leontodon1/1pps_flasher/README.md

# 1pps_flasher
flash device using pps signal and NMEA data of a GPS module for purpose of time stamping astronomical videos
