leontodon1/1pps_flasher/docs/speech_BjKa_ESOP45.pdf

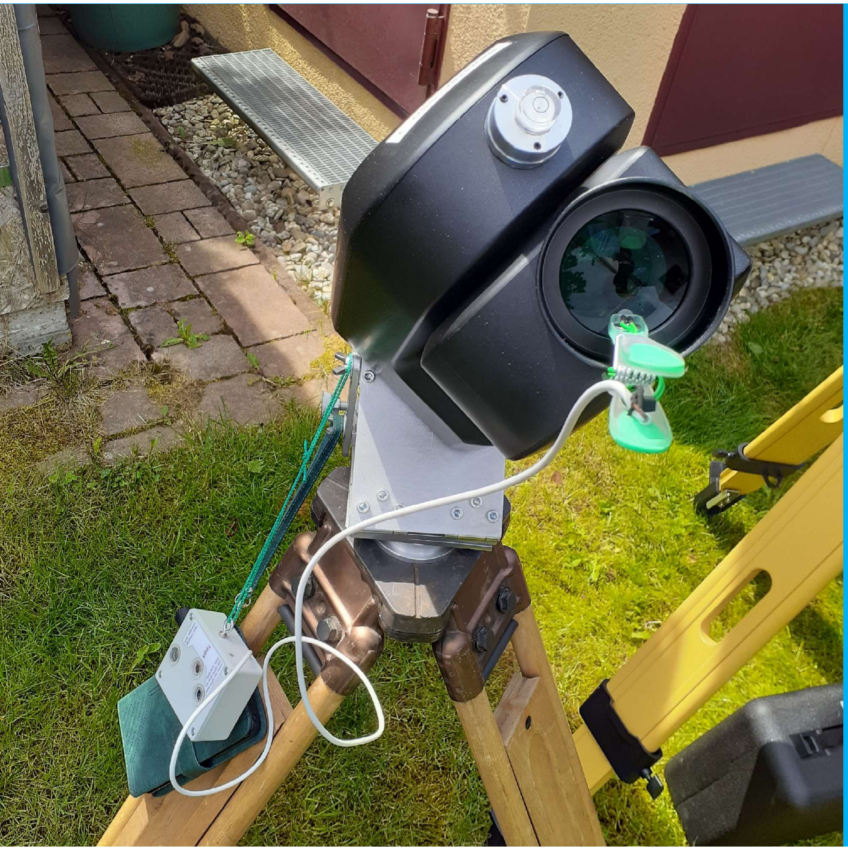
[picture p24: figure]

# Video Astronomie with Smart Telescopes?

Björn Kattentidt
ESOP 45
Toulouse, France
22./23. Aug. 2026

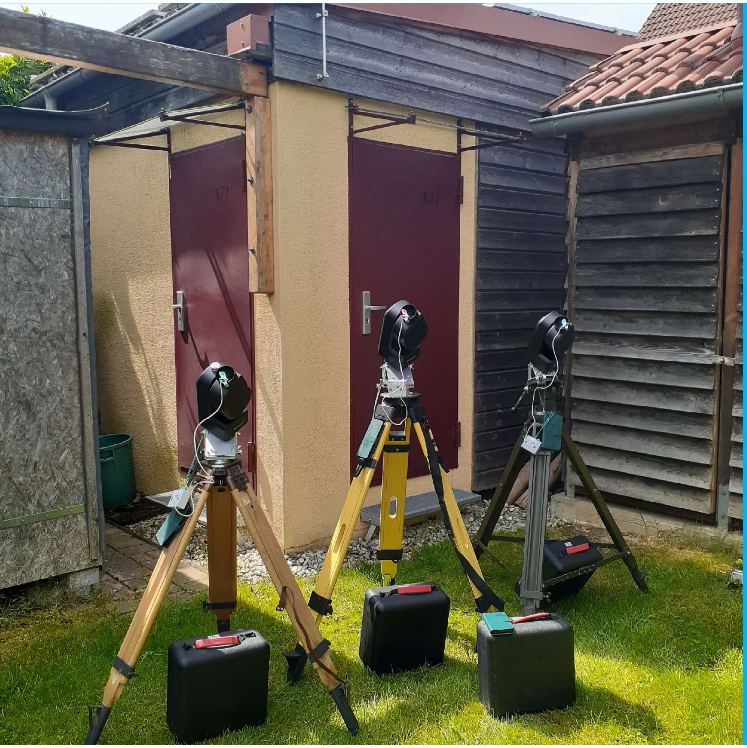
[picture p25: figure]

## Seestar S50

2

Observation of occultation of (5368) Vitagliano
March 12, 2026 with Bernd Gährken north of Regensburg
- Video with Seestar app
- Timestamp?? 1pps flasher
- Occult Watcher filter
- Signal-to-noise ratio?
- Magnitudes of S50 in video
- Event filtering with Excel
- DAMIT / ISAM
- Expedition
- Results

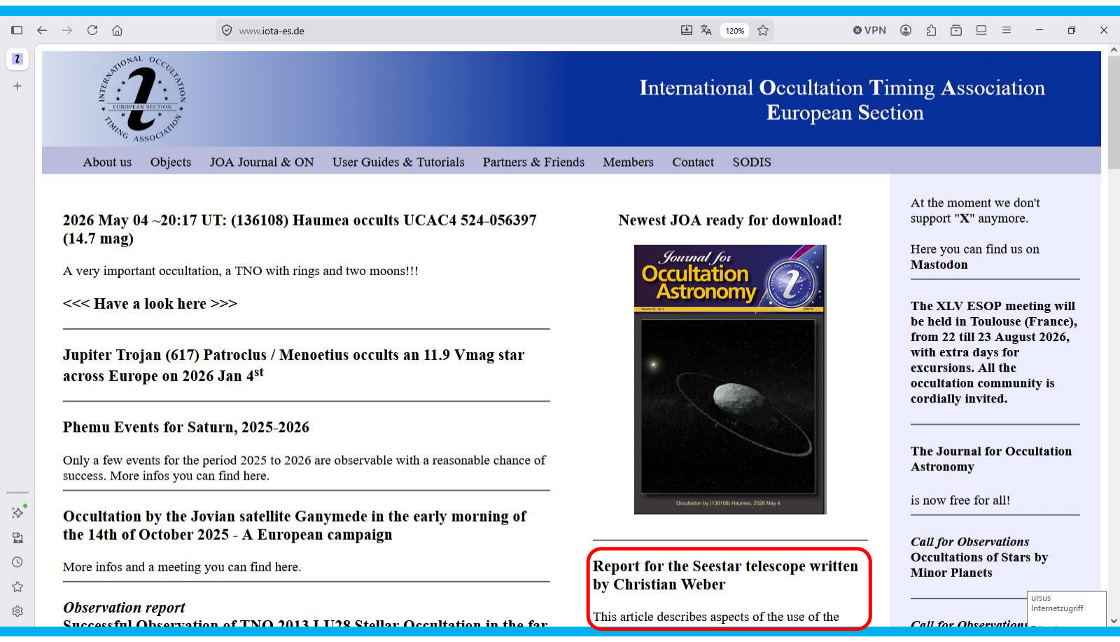
[picture p26: page 3]

3

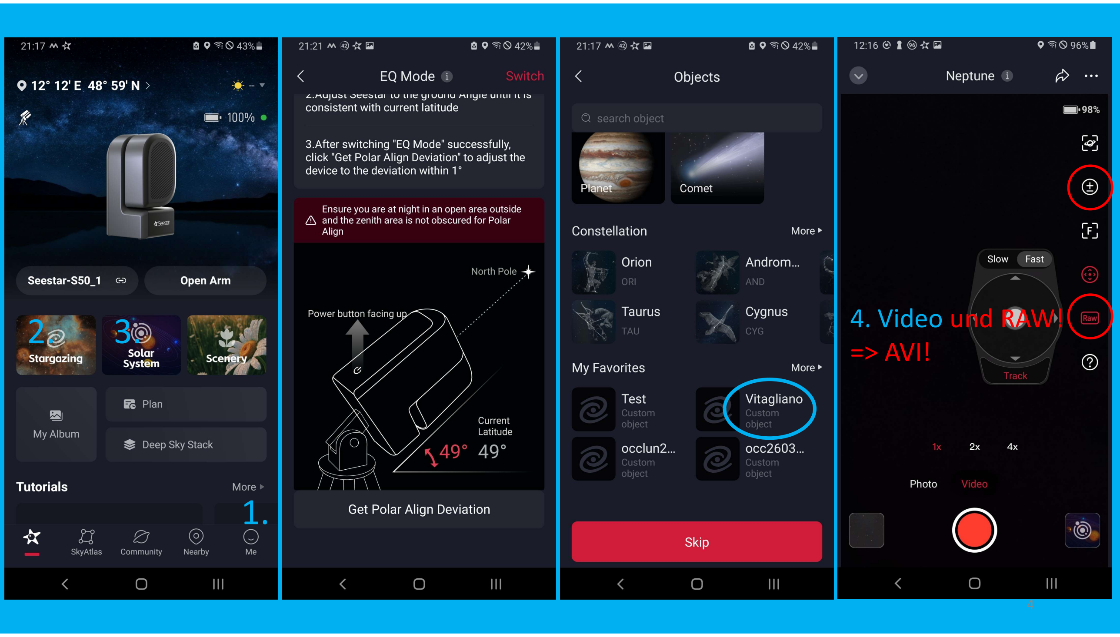
[picture p27: page 4]

4

1.

2. | 3. | 4. Video und RAW! => AVI!

## Timestamp? ->> 1 peak per second flash unit ->> task solved!

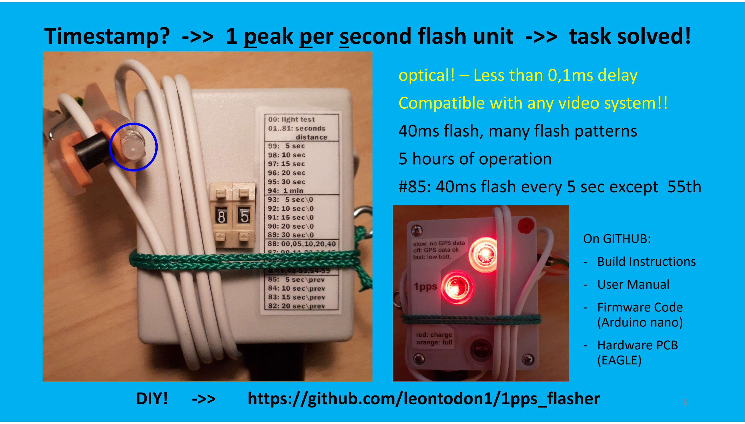
[picture p28: page 5]

5

optical! – Less than 0,1ms delay Compatible with any video system!! 40ms flash, many flash patterns

### 5 hours of operation

#85: 40ms flash every 5 sec except 55th

DIY! ->> https://github.com/leontodon1/1pps_flasher

On GITHUB:
- Build Instructions
- User Manual
- Firmware Code
(Arduino nano)
- Hardware PCB
(EAGLE)

## Timestamp on the S50

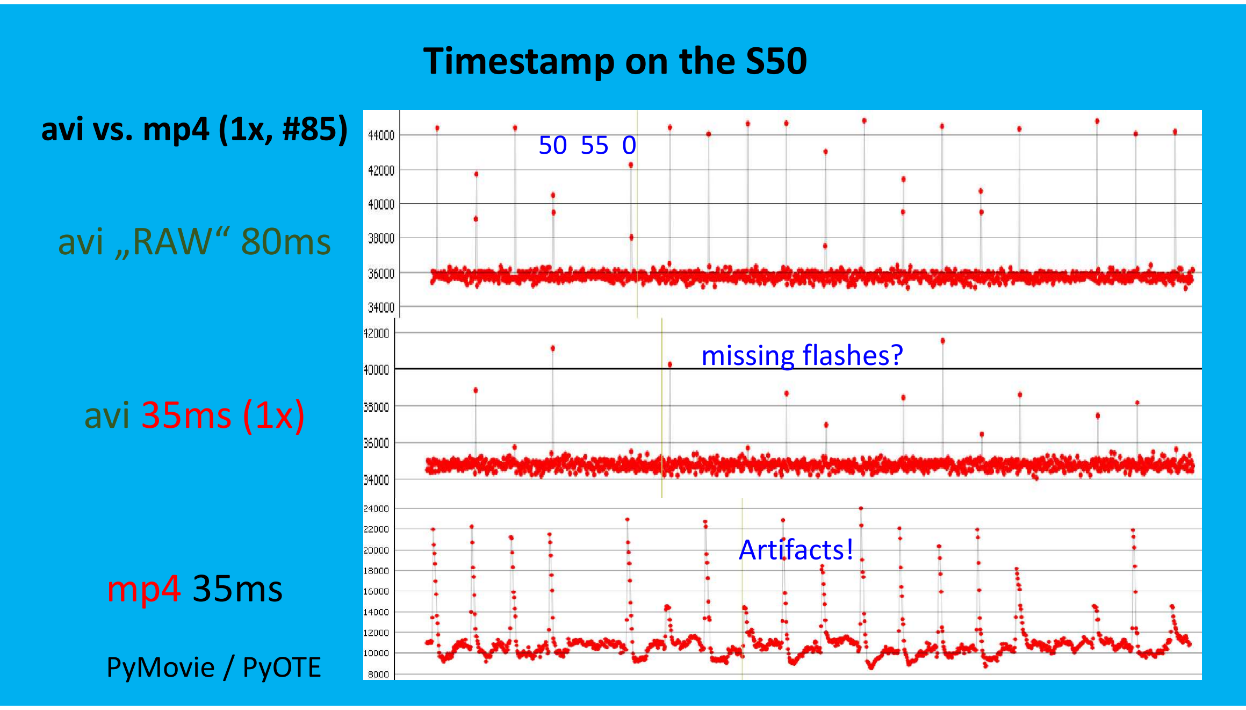
[picture p29: page 6]

6

avi vs. mp4 (1x, #85)

## avi „RAW“ 80ms

## avi 35ms (1x)

## mp4 35ms

missing flashes?

Artifacts!

50 55 0

PyMovie / PyOTE

## FOV formats

## Trap! Exposure time and fps on the S50

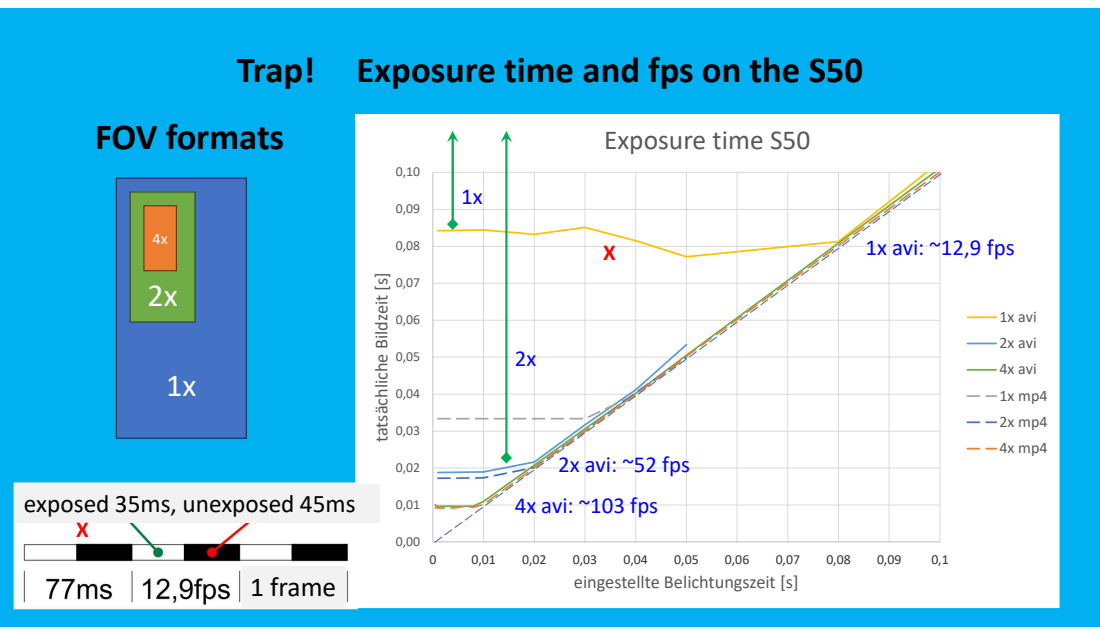
[picture p30: page 7]
0,1 tatsächliche Bildzeit [s]; eingestellte Belichtungszeit [s]; Exposure time S50; 1x avi 2x avi 4x avi 1x mp4 2x mp4 4x mp4; 2x avi: ~52 fps; X 1x avi: ~12,9 fps; 4x avi: ~103 fps; exposed 35ms, unexposed 45ms X; 1 frame

## Occult Watcher – Event Filter

8

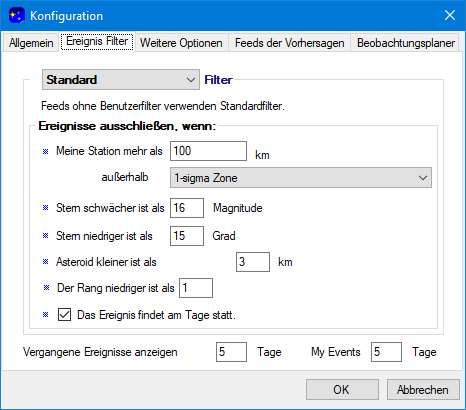
[picture p31: figure]

Filters required for the S50 mobile:

distance earth's surface < 30 km
drop | > 2,5mag
Desired result:
- max frames possible (frm_max 3)
=> Filter!
- shortest possible exposure time t_exp_min (SNR > 3)
Martin Gutekunst, 2025 ESOP 44 at Posen/PL
Parameter for t_exp_min, frm_max

optics: focal length, aperture
camera: pixel size, binning, sensitivity
OW: duration, brightness, mag drop, distance

## max. magnitude on S50 - h~45°

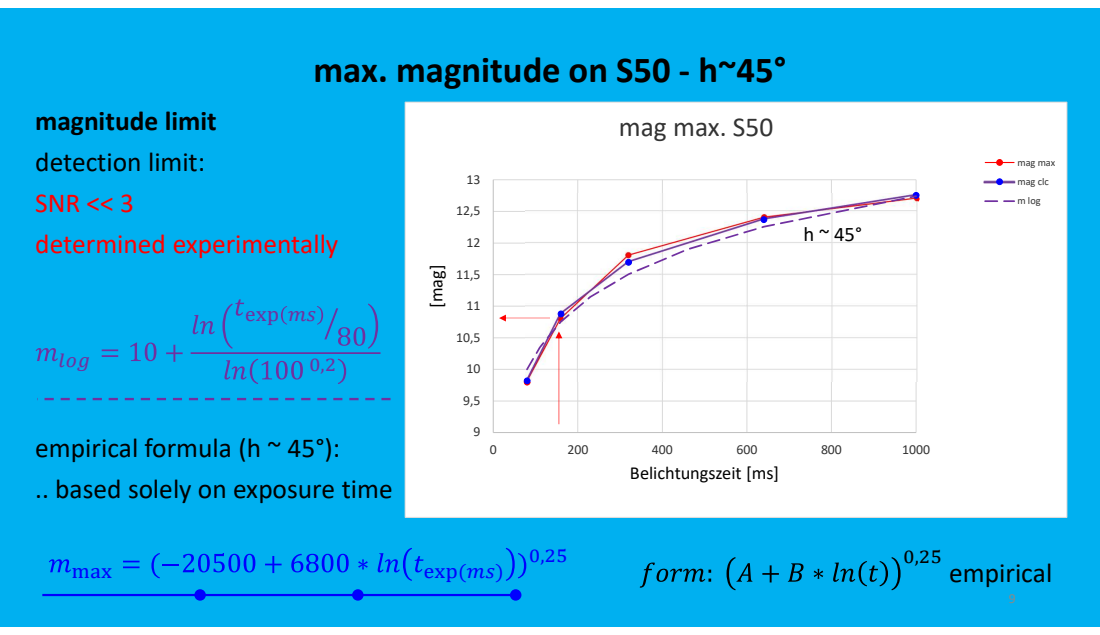
[picture p32: page 9]
1000 [mag]; Belichtungszeit [ms]; mag max. S50; mag max; mag clc; m log; magnitude limit detection limit: SNR << 3 determined experimentally; , empirical

empirical formula (h ~ 45°):
.. based solely on exposure time

## Signal to noise ratio on S50

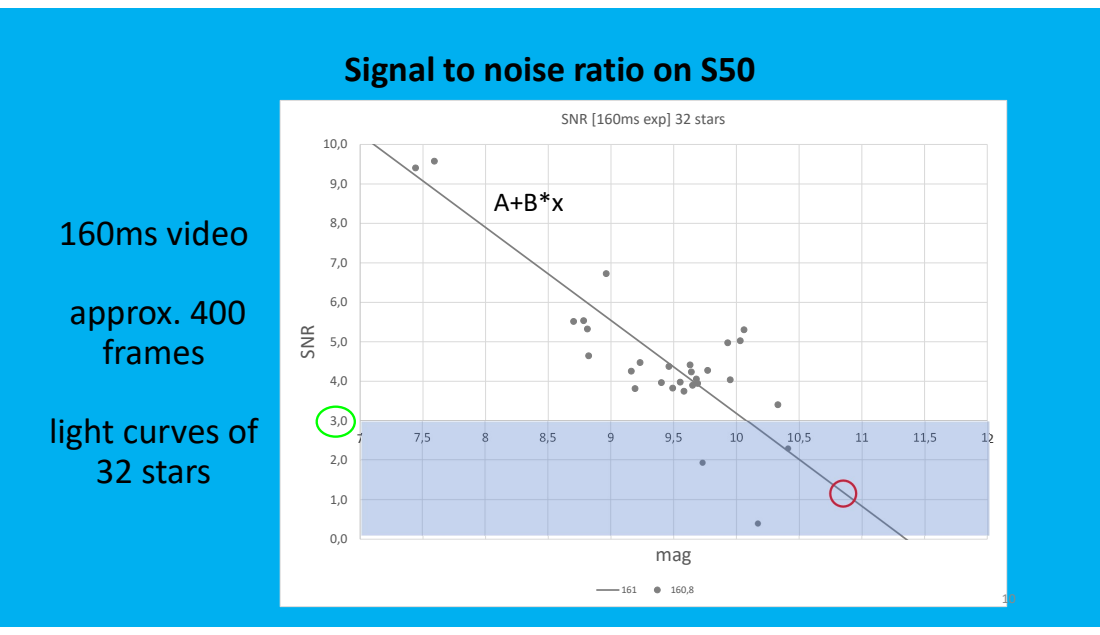
[picture p33: page 10]
12 SNR; mag; 160ms video; approx. 400 frames; light curves of 32 stars

SNR [160ms exp] 32 stars

## Signal to noise ratio on S50

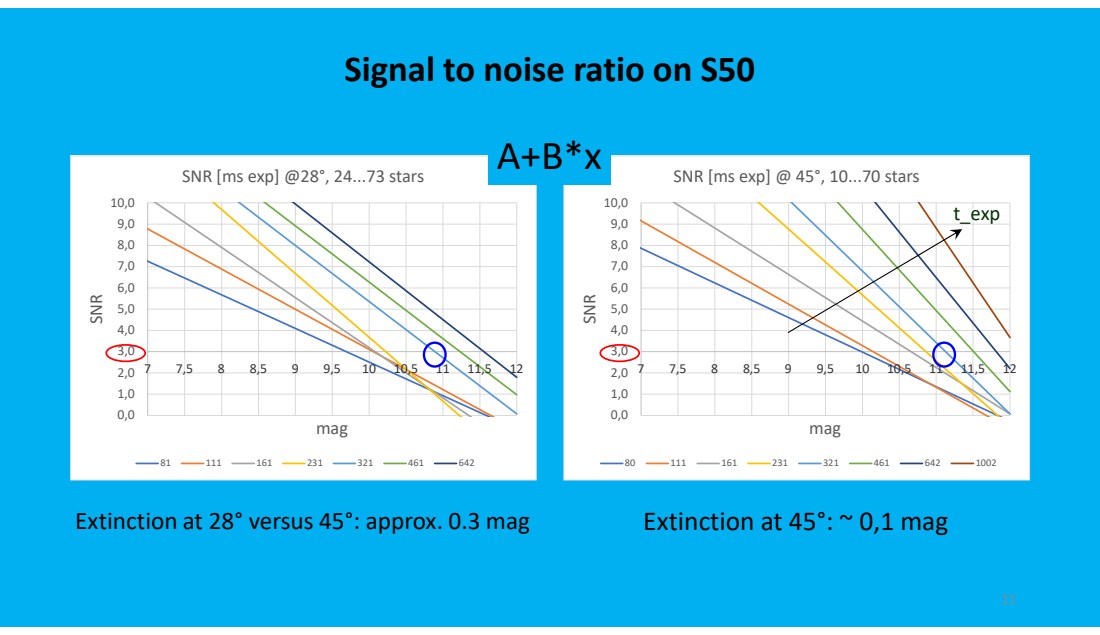
[picture p34: page 11]
10 10,5 11 11,5 12 SNR; mag; Extinction at 28° versus 45°: approx. 0.3 mag; Extinction at 45°: ~ 0,1 mag; t_exp

SNR [ms exp] @28°, 24...73 stars

SNR [ms exp] @ 45°, 10...70 stars

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

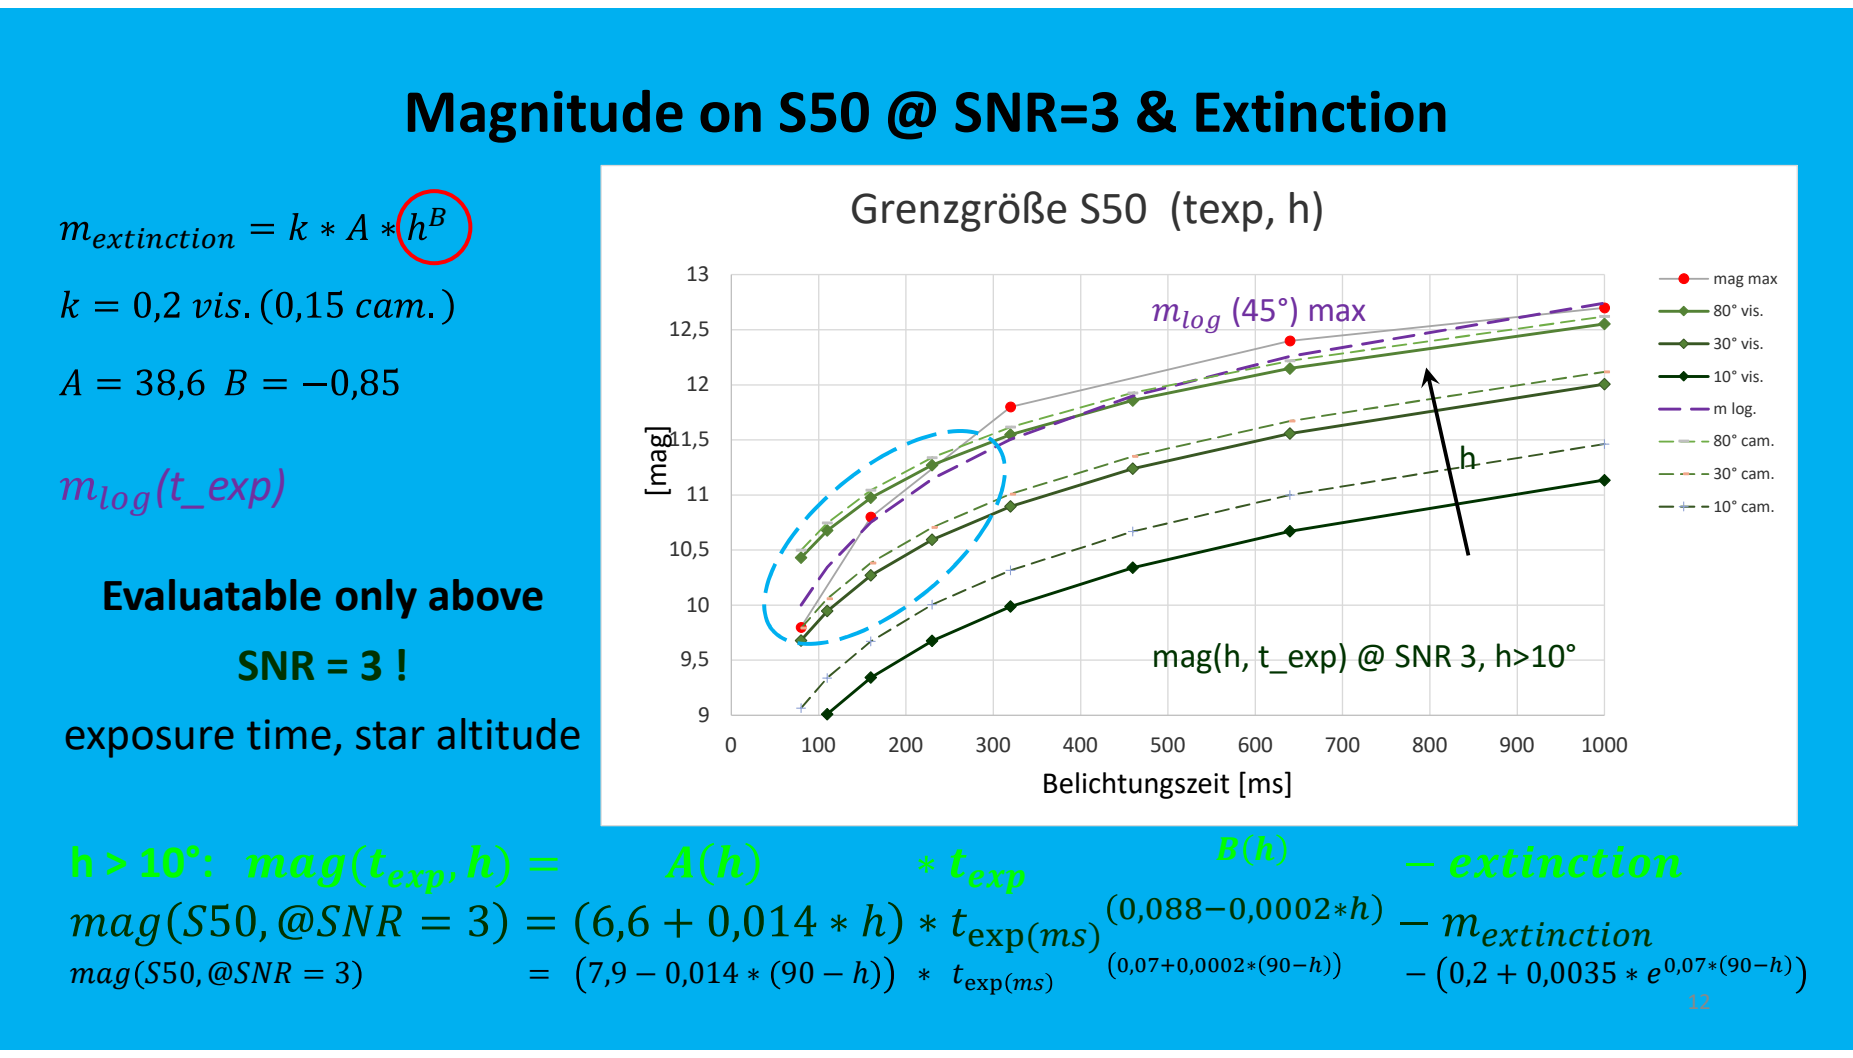
[picture p35: page 12]

## Occult Watcher extract - 3 winter months: 2800 events

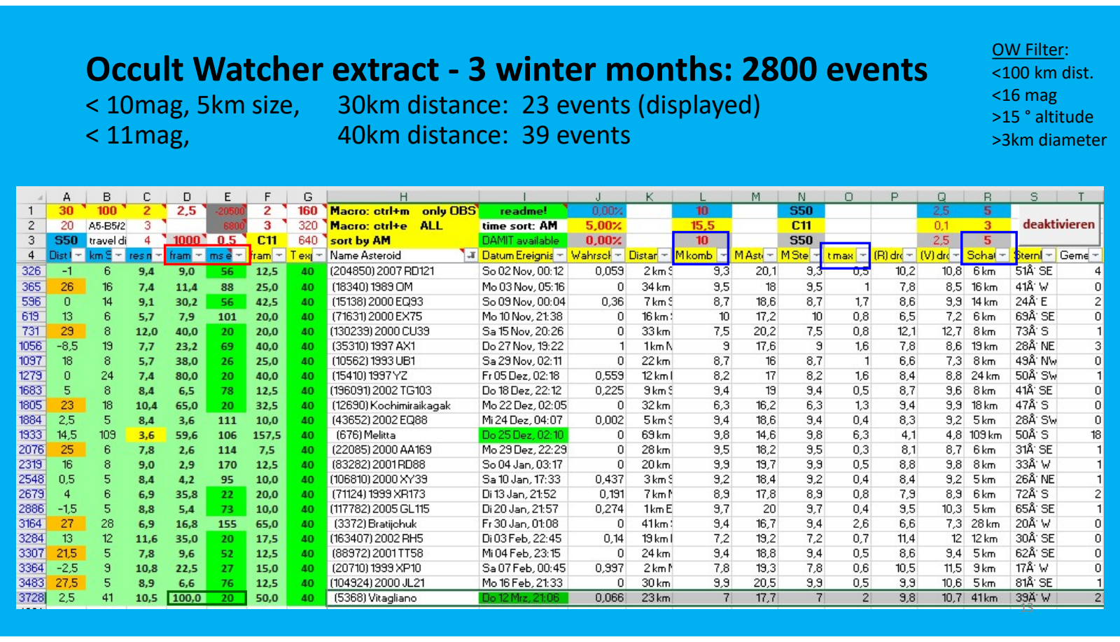
[picture p36: page 13]

< 10mag, 5km size, 30km distance: 23 events (displayed)
< 11mag, | 40km distance: 39 events

13

OW Filter:
<100 km dist.
<16 mag
>15 ° altitude
>3km diameter

## OW Cloud Filter

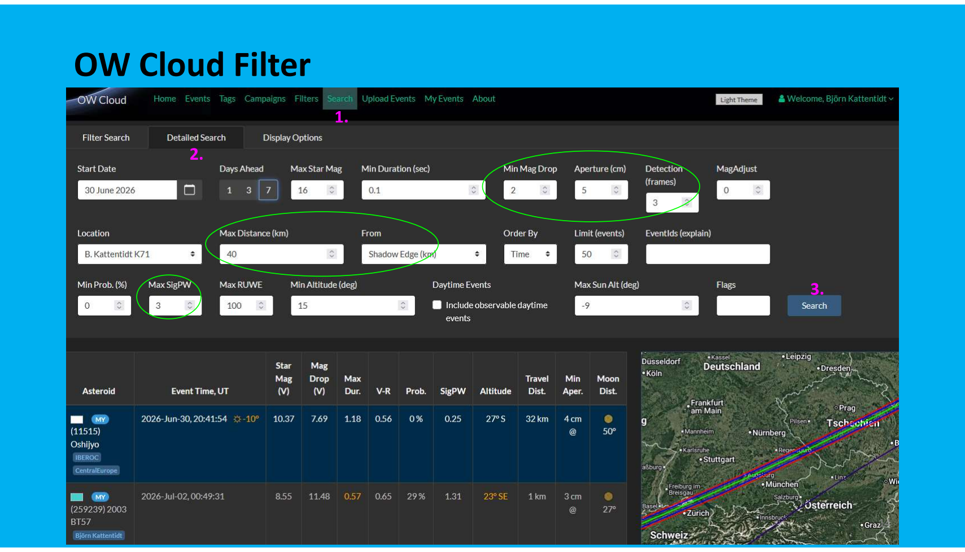
[picture p37: page 14]

14

1.
2.

3.

## JPL page

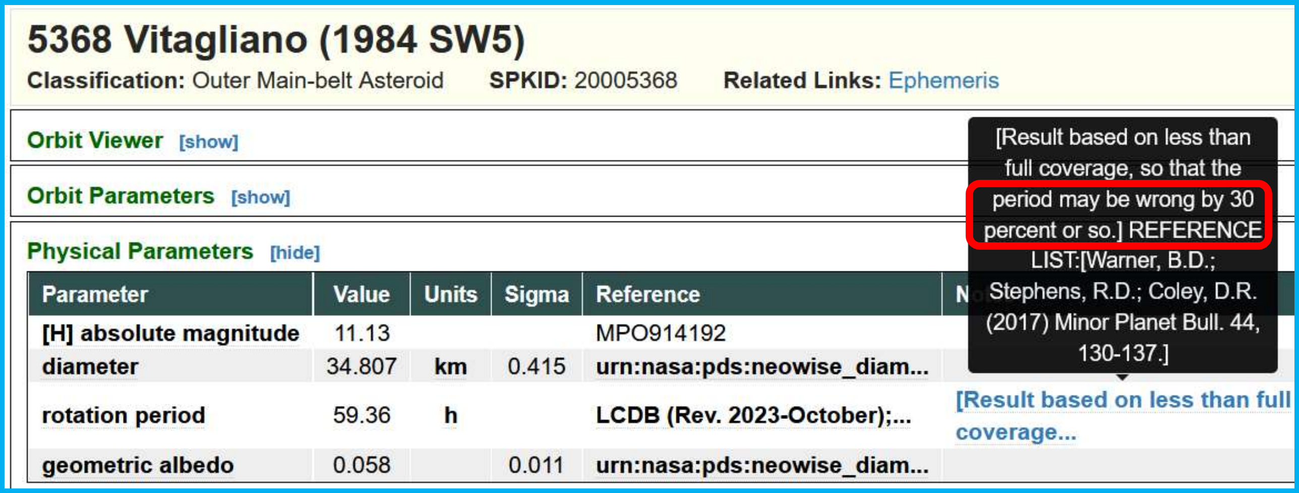
[picture p38: figure]

15

https://ssd.jpl.nasa.gov/horizons

## (5368) Vitagliano – DAMIT (Uni Prag)

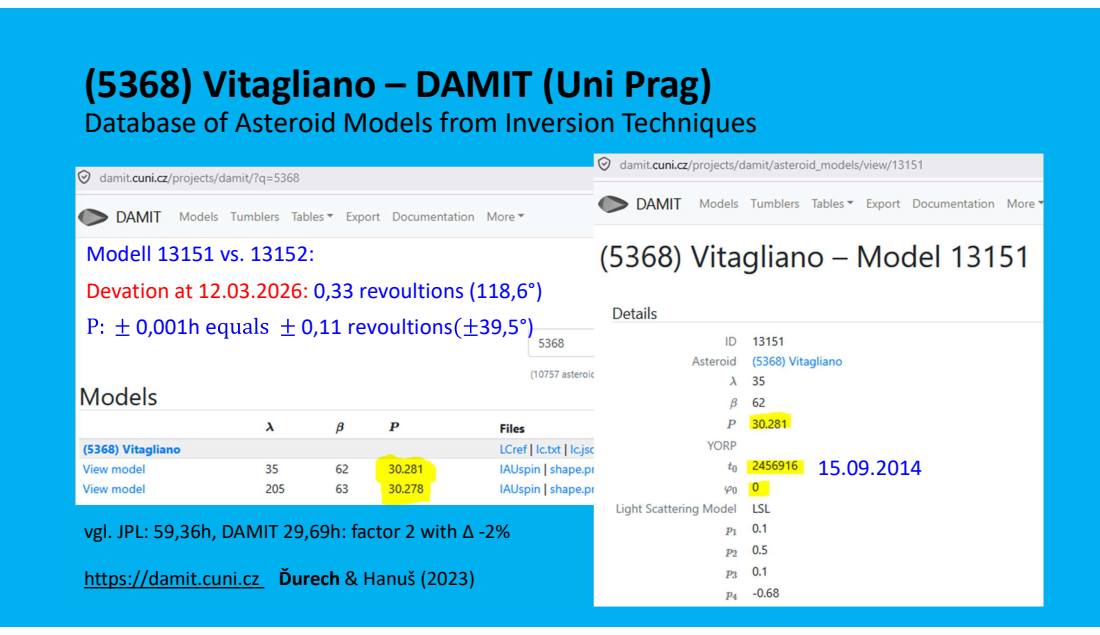
[picture p39: page 16]
0,11 revoultions

Database of Asteroid Models from Inversion Techniques

Modell 13151 vs. 13152:
Devation at 12.03.2026: 0,33 revoultions (118,6°)

vgl. JPL: 59,36h, DAMIT 29,69h: factor 2 with Δ -2%
https://damit.cuni.cz Ďurech & Hanuš (2023)

## (5368) Vitagliano – ISAM

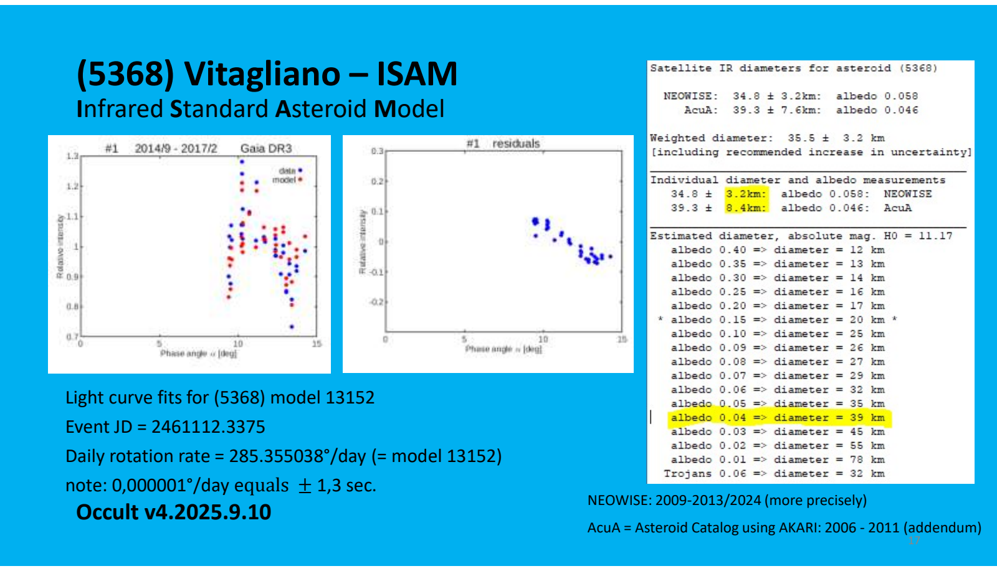
[picture p40: page 17]

Light curve fits for (5368) model 13152
Event JD = 2461112.3375
Daily rotation rate = 285.355038°/day (= model 13152) note: 0,000001°/day equals ± 1,3 sec.

Infrared Standard Asteroid Model

17

Occult v4.2025.9.10 | NEOWISE: 2009-2013/2024 (more precisely) AcuA = Asteroid Catalog using AKARI: 2006 - 2011 (addendum)

## (5368) Vitagliano – DAMIT model 13151, 13152 (occult4)

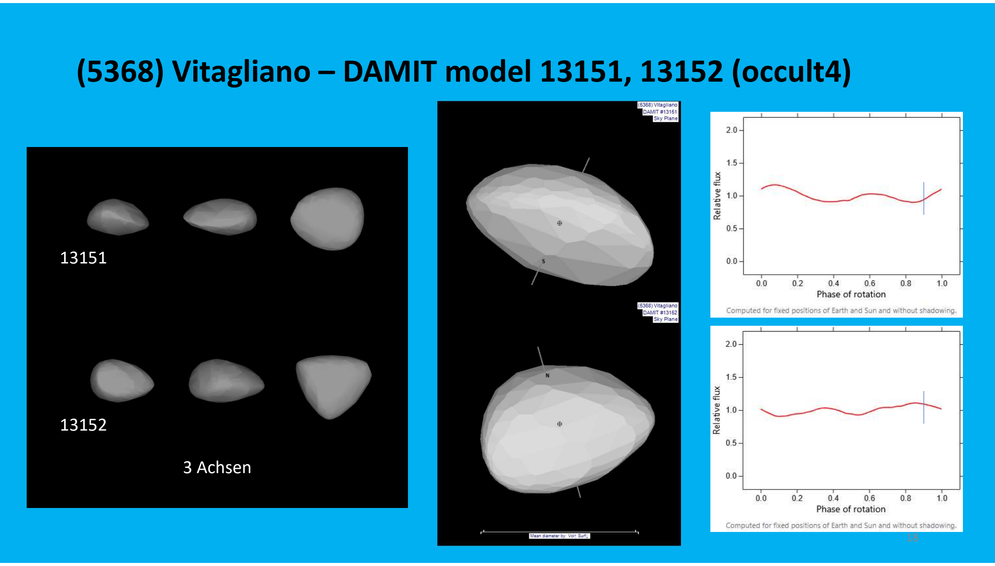
[picture p41: page 18]

18

### 3 Achsen

13151

13152

## (5368) Vitagliano – animated 30h

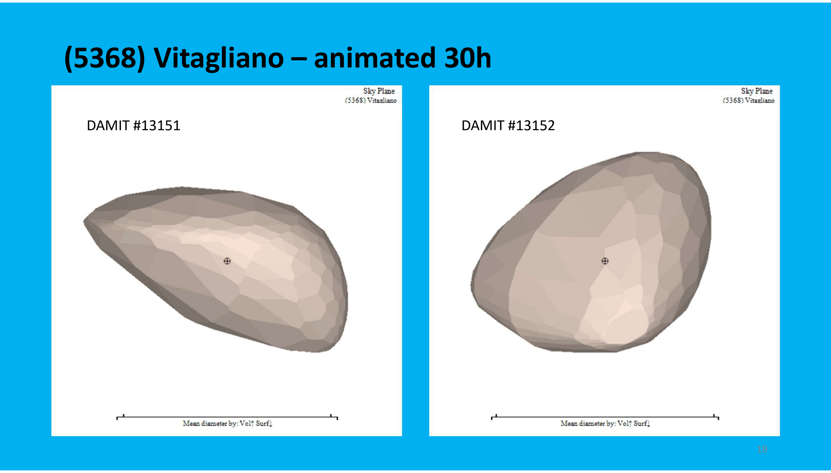
[picture p42: page 19]

19

DAMIT #13151 | DAMIT #13152

(5368) Vitagliano – animated ±5° / ±25 min.

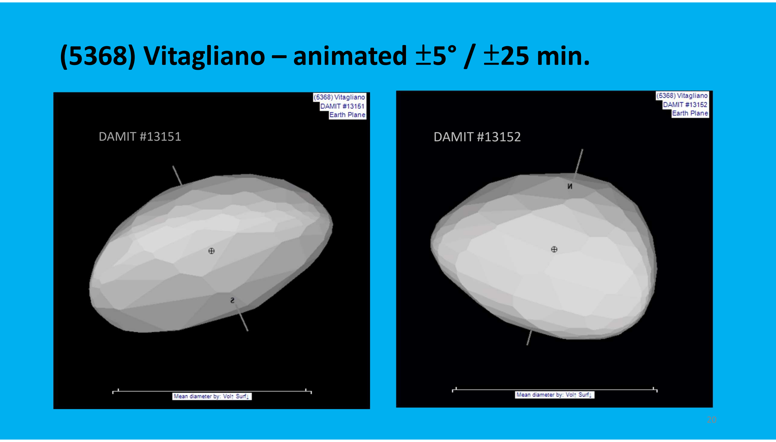
[picture p43: page 20]

20

DAMIT #13151 DAMIT #13151 | DAMIT #13152

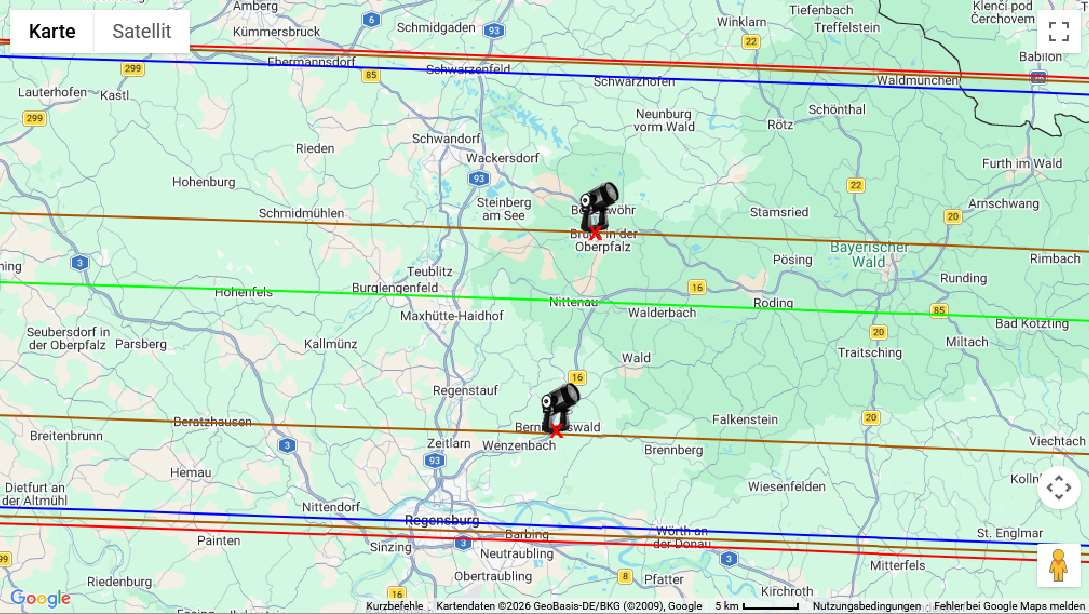
[picture p44: figure]

21

## Expedition: Star occultation path and site planning

## Projection as a spherical asteroid

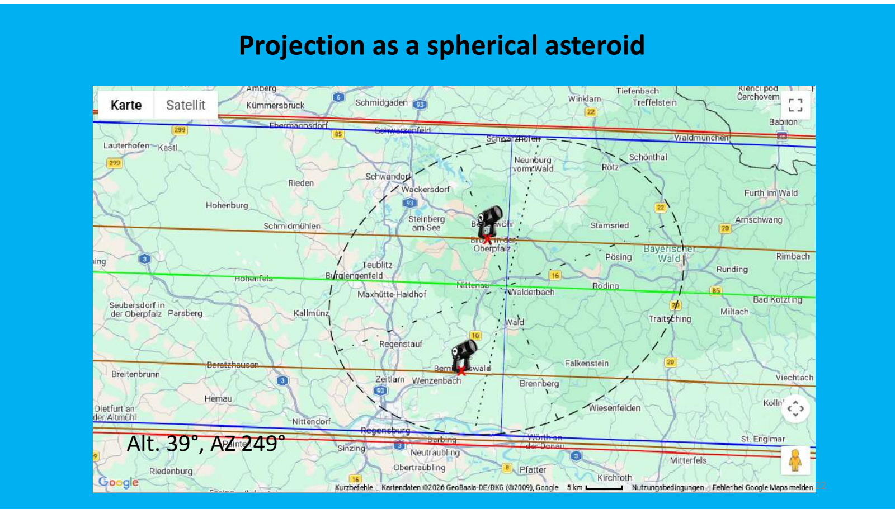
[picture p45: page 22]

22

Alt. 39°, AZ 249°

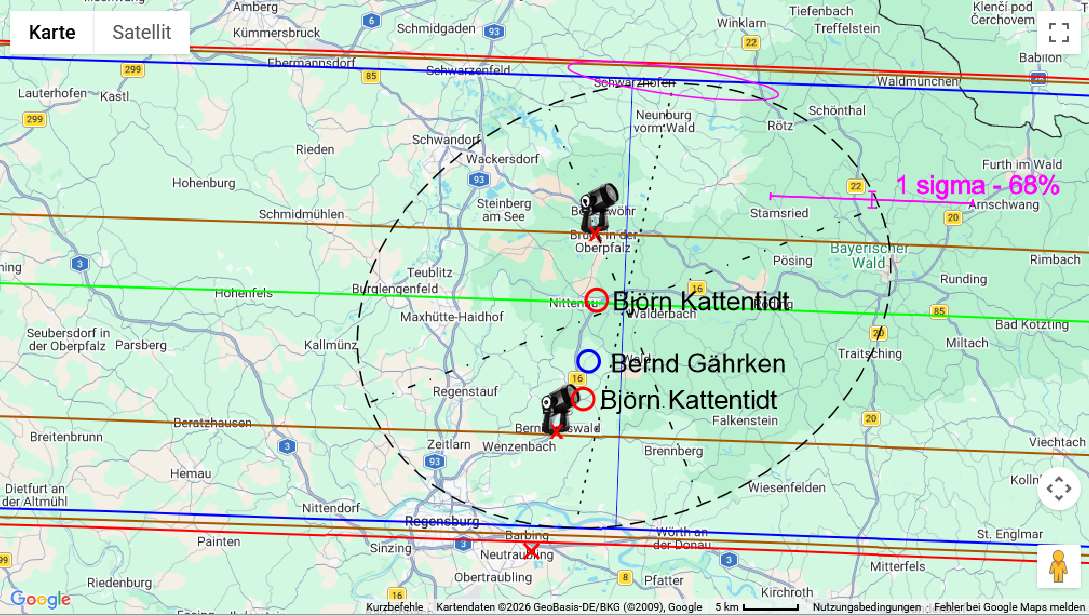
[picture p46: figure]

23

## Actual observation locations

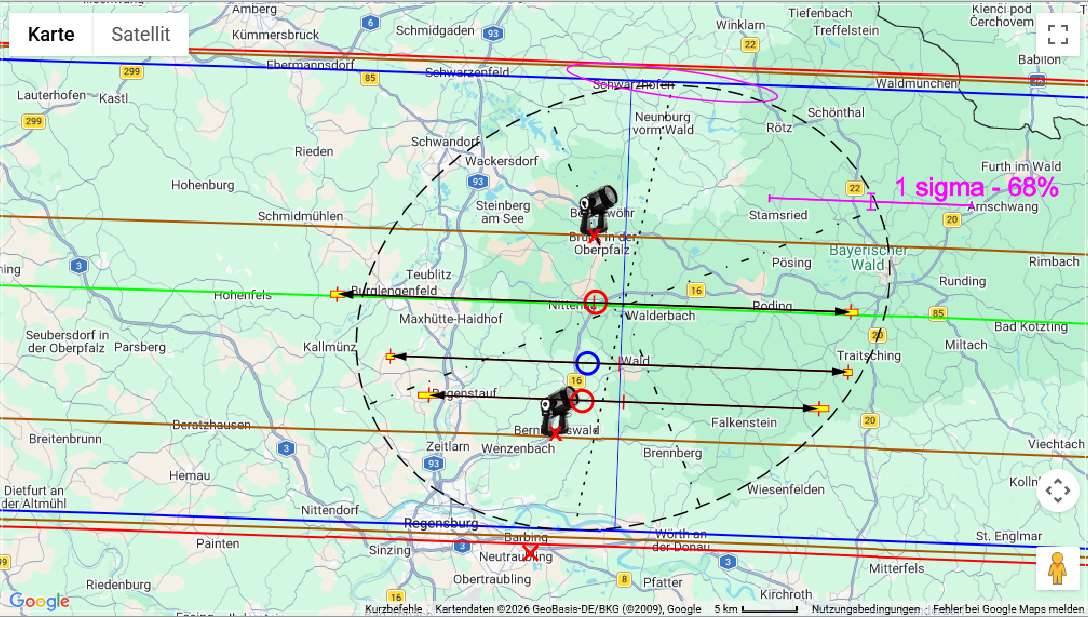
[picture p47: figure]

24

## Measured times, projected and shifted

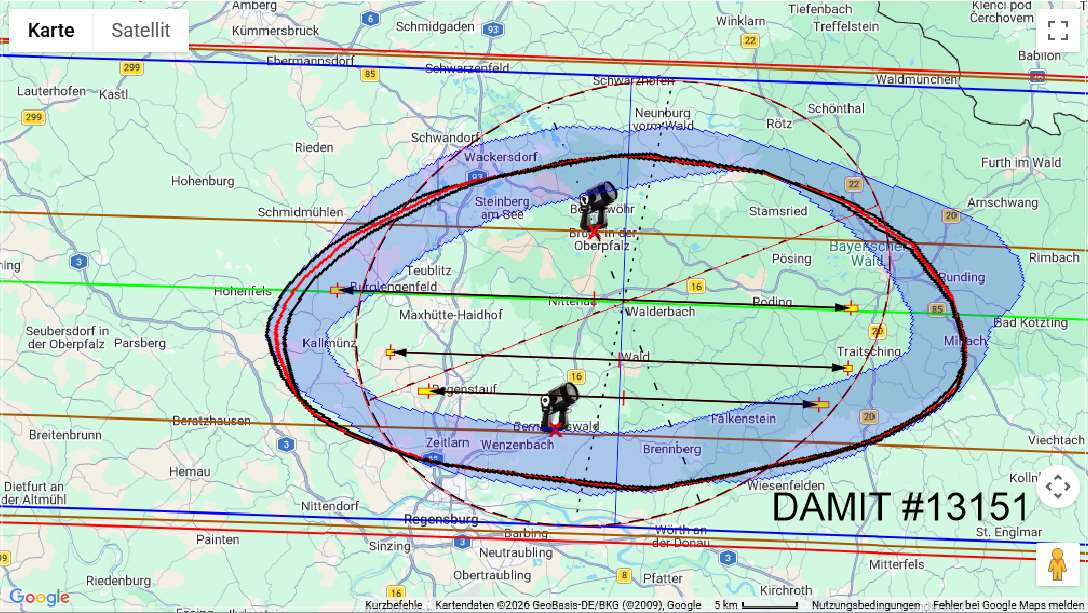
[picture p48: figure]

25

## (5368) Vitagliano – model #1

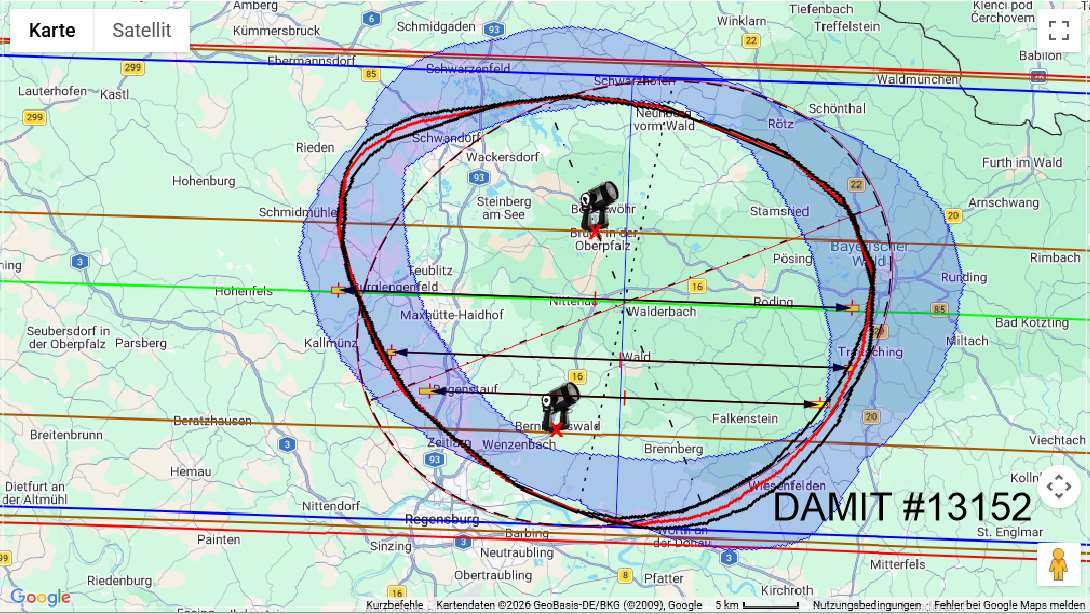
[picture p49: figure]

26

## (5368) Vitagliano – model #2

## Result

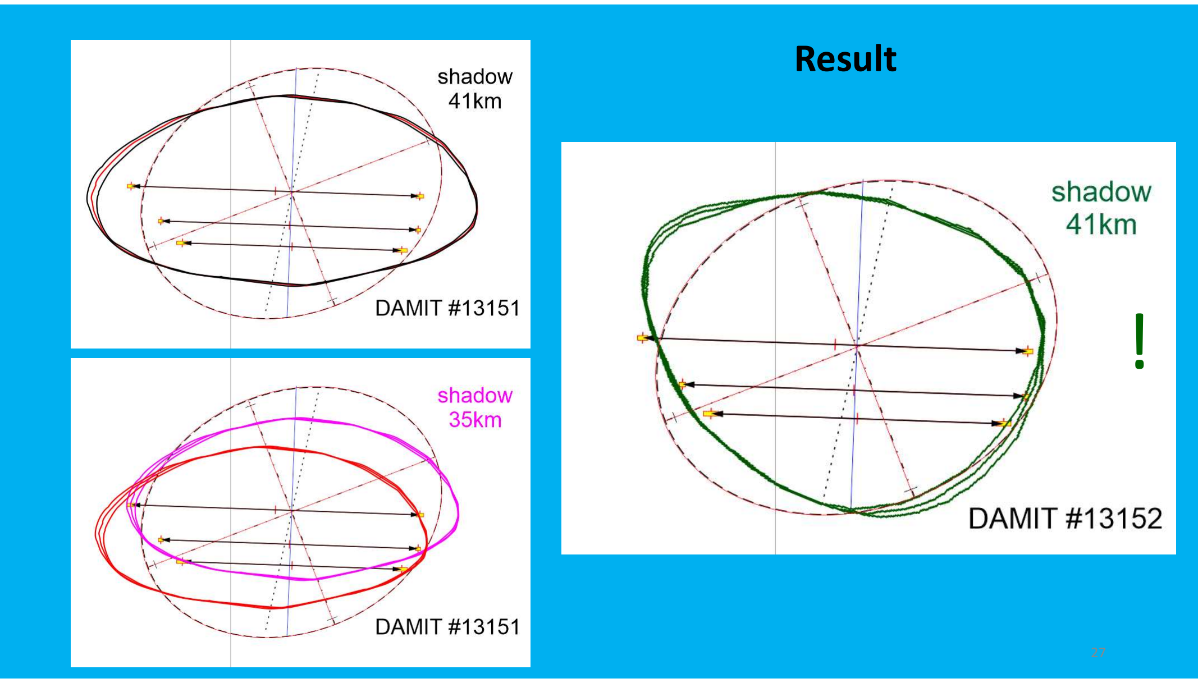
[picture p50: page 27]

27

!

## (5368) Vitagliano – model #2

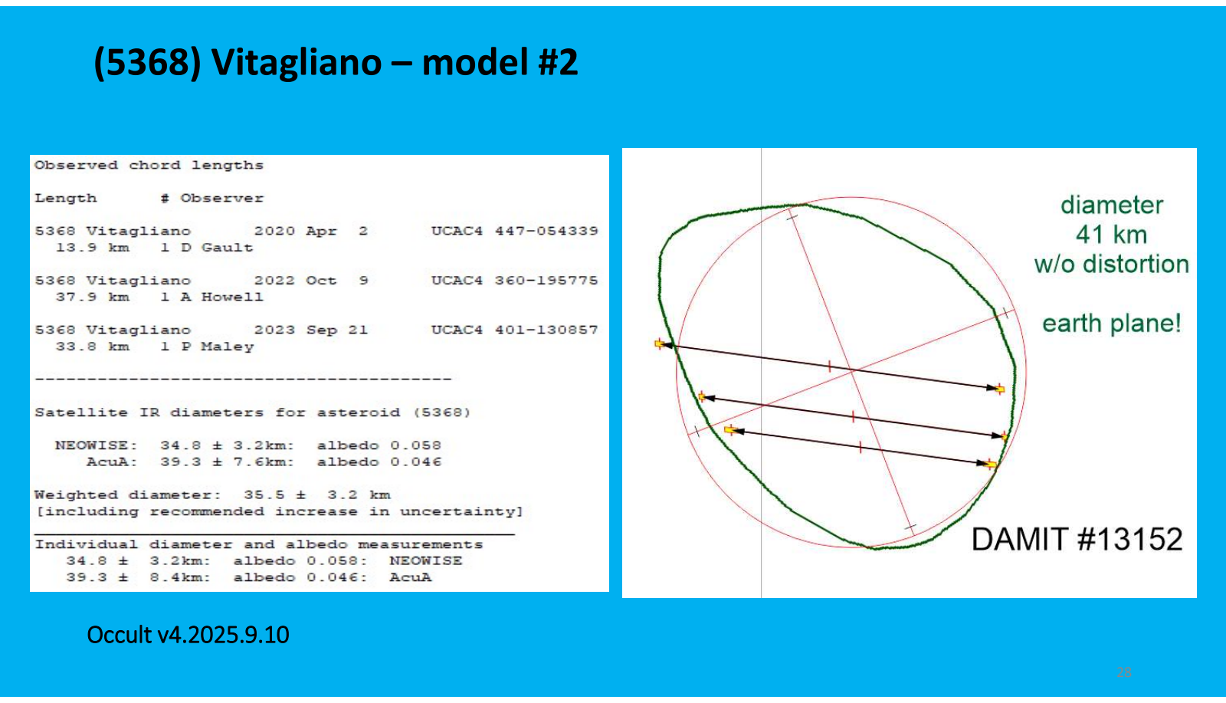
[picture p51: page 28]

28

!

Occult v4.2025.9.10

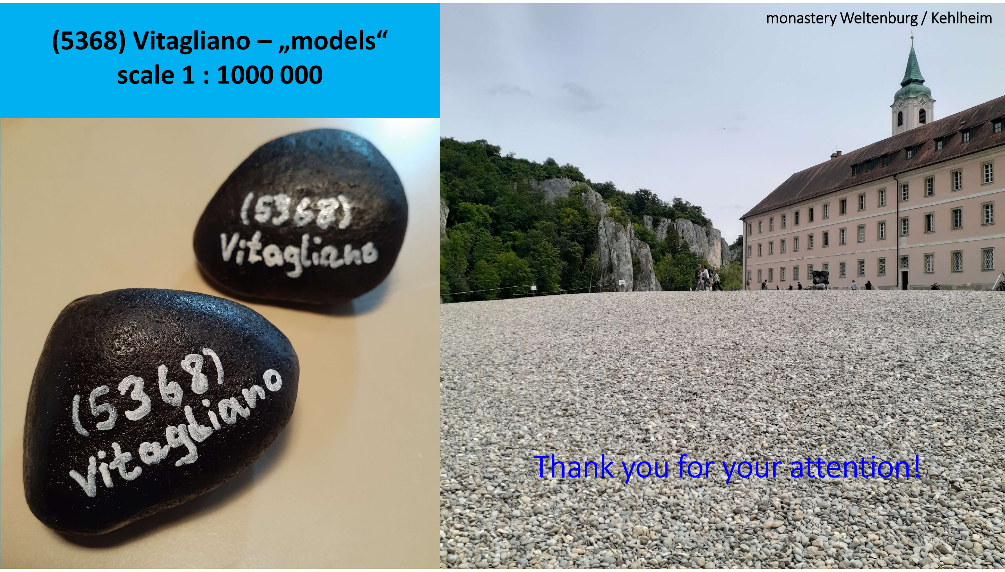
[picture p52: page 29]

29

## Thank you for your attention!

(5368) Vitagliano – „models“ scale 1 : 1000 000

monastery Weltenburg / Kehlheim

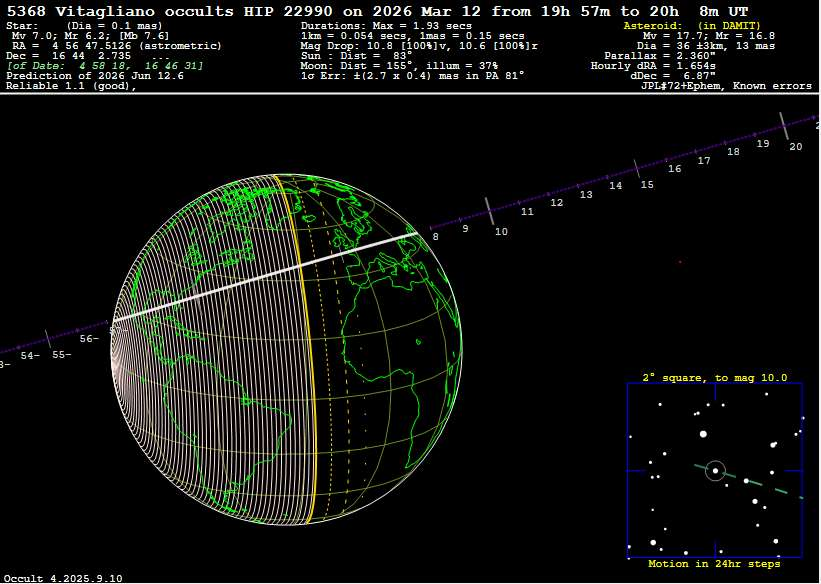
[picture p53: figure]

30

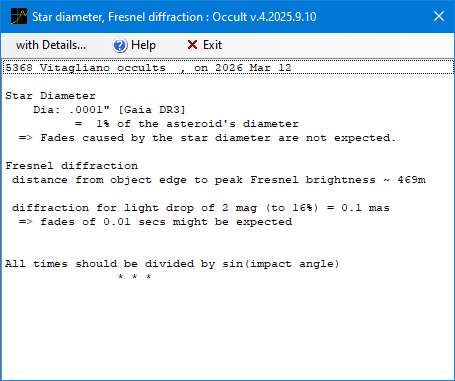
[picture p54: figure]

31
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
