leontodon1/1pps_flasher/docs/260922_Vortrag_SSW.pdf

## Video Astronomie mit Smart Telescopen?

Björn Kattentidt
Heppenheim

### 22. September 2026


Seestar S50

2

Beobachtung der Sternbedeckung von (5368) Vitagliano
am 12.03.2026 mit Bernd Gährken nördlich Regensburg
- Video mit Seestar app
- Zeitstempel?? 1pps Blitzer
- Filter Occult Watcher
- Signal-Rausch-Verhältnis?
- Magnituden des S50 bei Video
- Ereignis Filterung mit Excel
- DAMIT / ISAM
- Expedition
- Ergebnisse


3


4

1.

2. | 3. | 4. Video und RAW! => AVI!

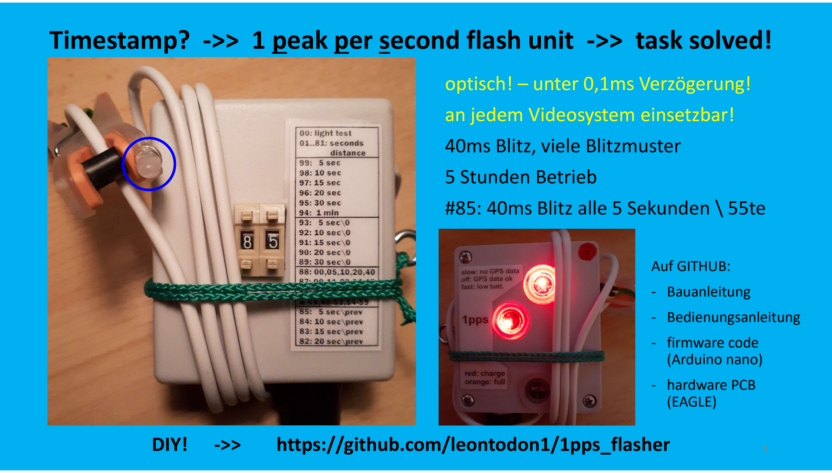
[picture p68: page 5]

5

Timestamp? ->> 1 peak per second flash unit ->> task solved!

optisch! – unter 0,1ms Verzögerung! an jedem Videosystem einsetzbar! 40ms Blitz, viele Blitzmuster

### 5 Stunden Betrieb

#85: 40ms Blitz alle 5 Sekunden \ 55te

DIY! ->> https://github.com/leontodon1/1pps_flasher

Auf GITHUB:
- Bauanleitung
- Bedienungsanleitung
- firmware code
(Arduino nano)
- hardware PCB
(EAGLE)

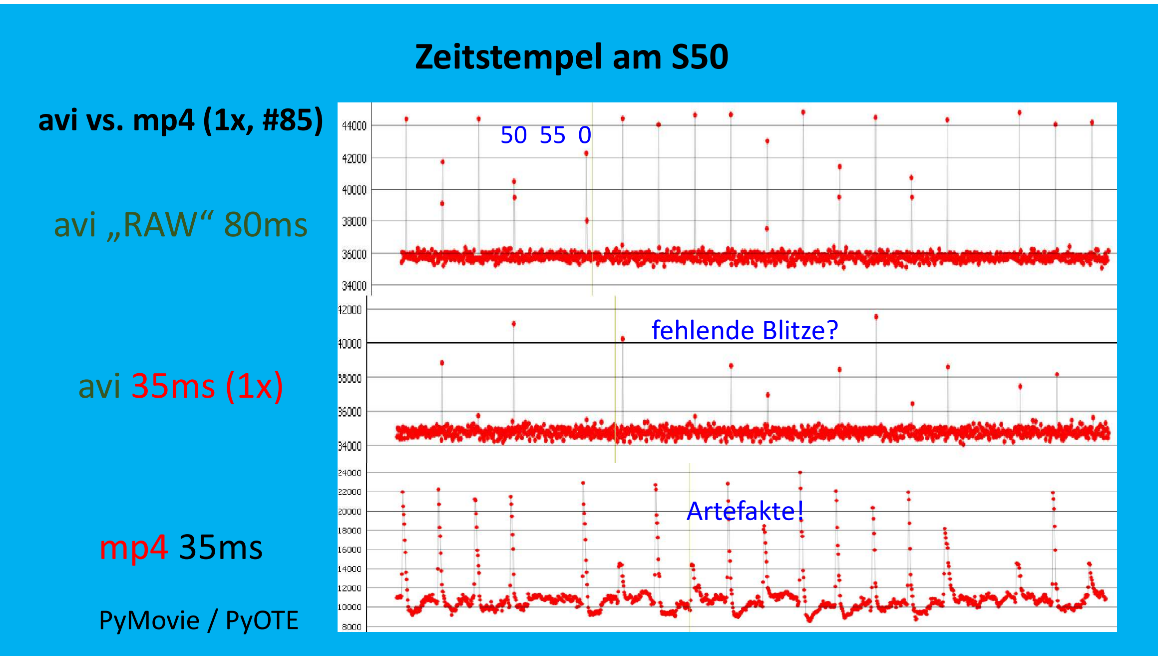
[picture p69: page 6]

Zeitstempel am S50

6

avi vs. mp4 (1x, #85)

avi „RAW“ 80ms

avi 35ms (1x)

mp4 35ms

fehlende Blitze?

Artefakte!

50 55 0

PyMovie / PyOTE

### Achtung Falle! Belichtungszeit und fps beim S50

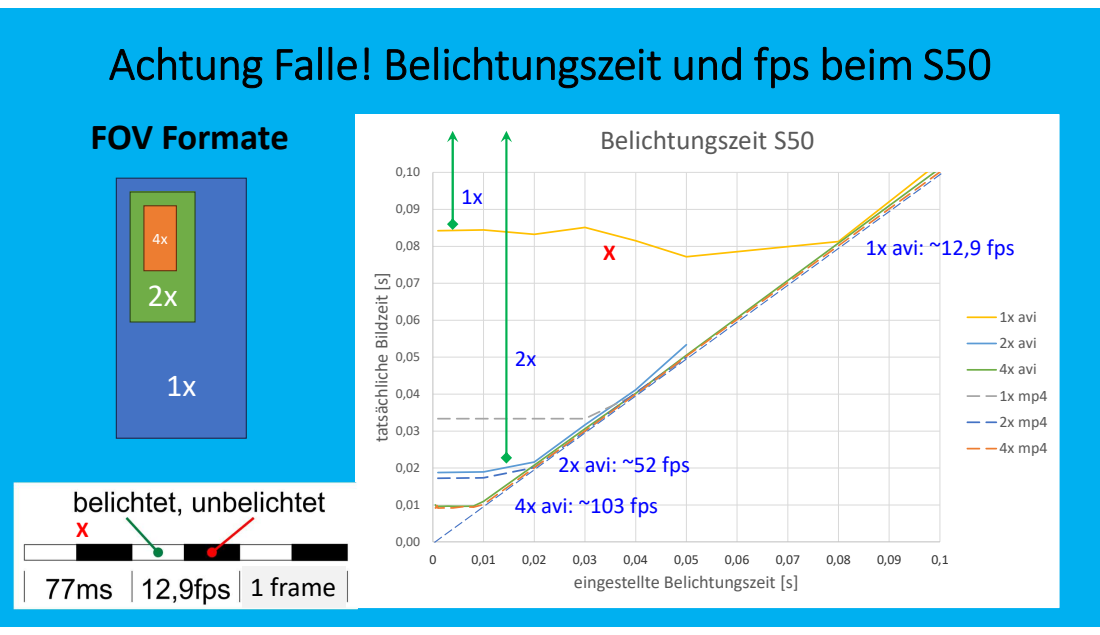
[picture p70: page 7]
0,1 tatsächliche Bildzeit [s]; eingestellte Belichtungszeit [s]; Belichtungszeit S50; 1x avi 2x avi 4x avi 1x mp4 2x mp4 4x mp4; FOV Formate; 2x avi: ~52 fps; X 1x avi: ~12,9 fps; 4x avi: ~103 fps; 1 frame

Occult Watcher - Ereignis Filter

8


Benötigte Filter für S50 mobil:
Distanz Erdoberfläche | < 30 km
drop | > 2,5mag
gesuchtes Ergebnis:
- Bilder maximal möglich (frames_max 3) => Filter!
- kleinst mögliche Belichtungszeit t_exp_min (SNR > 3) Martin Gutekunst, 2025 ESOP 44 in Posen/PL
Parameter für
t_exp_min, frames_max
Optik: Brennweite, Öffnung Kamera: Pixelgröße, binning, Empfindlichkeit OW: Dauer, Helligkeit, mag drop, Distanz

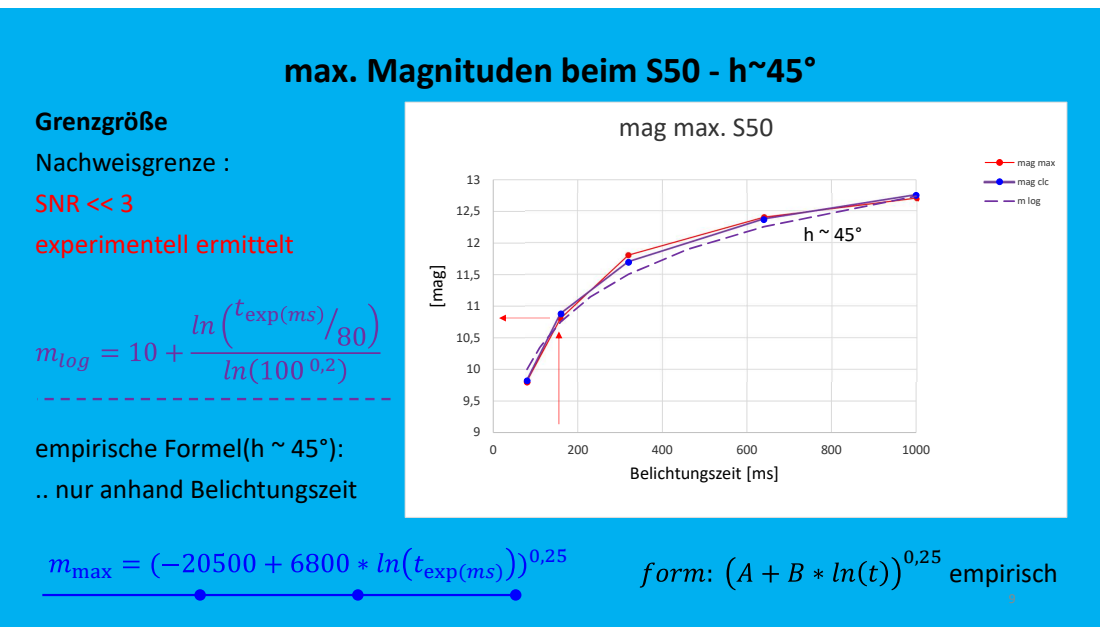
[picture p71: page 9]
1000 [mag]; Belichtungszeit [ms]; mag max. S50; mag max; mag clc; m log; Grenzgröße Nachweisgrenze : SNR << 3 experimentell ermittelt; , empirisch

max. Magnituden beim S50 - h~45°

empirische Formel(h ~ 45°):
.. nur anhand Belichtungszeit

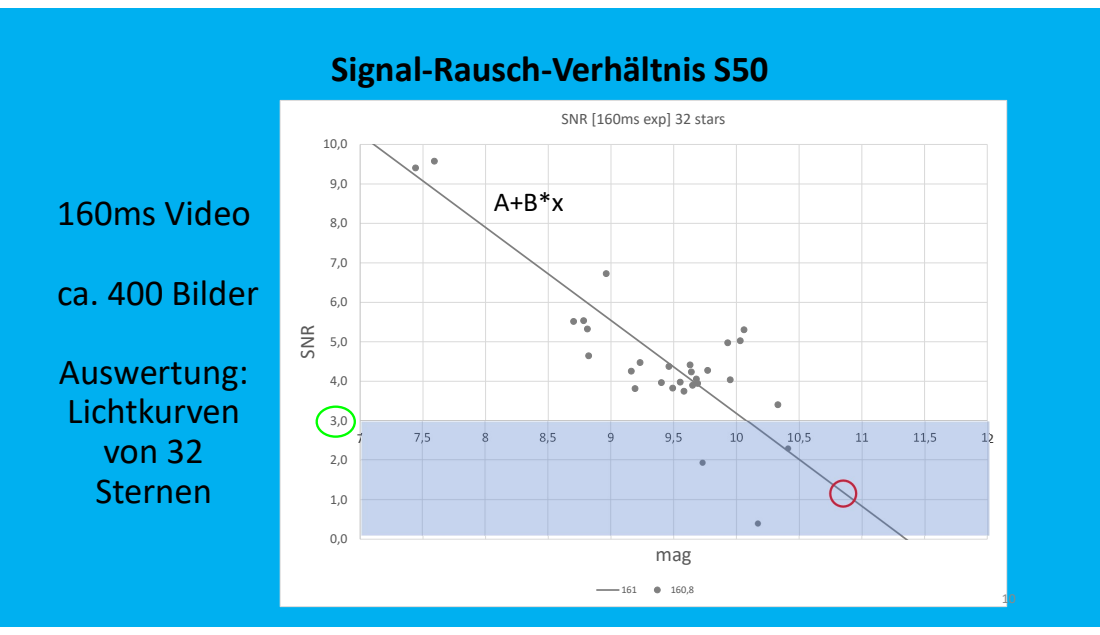
[picture p72: page 10]
12 SNR; mag; 160ms Video; ca. 400 Bilder; Auswertung: Lichtkurven von 32 Sternen

Signal-Rausch-Verhältnis S50

SNR [160ms exp] 32 stars

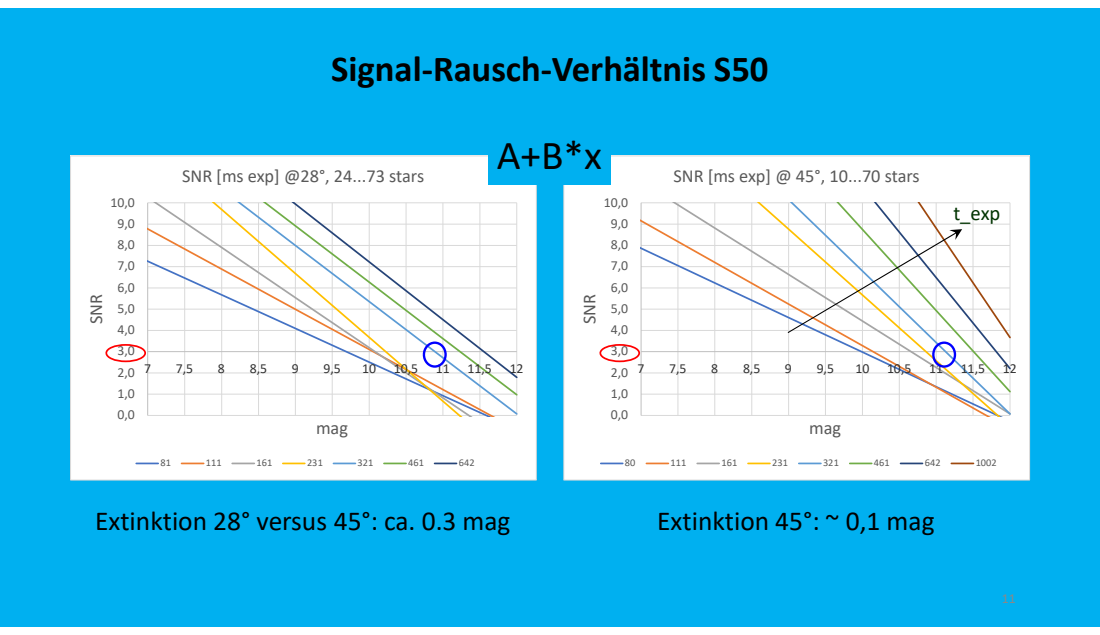
[picture p73: page 11]
10 10,5 11 11,5 12 SNR; mag; Extinktion 28° versus 45°: ca. 0.3 mag; Extinktion 45°: ~ 0,1 mag; t_exp

Signal-Rausch-Verhältnis S50

SNR [ms exp] @28°, 24...73 stars

SNR [ms exp] @ 45°, 10...70 stars

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

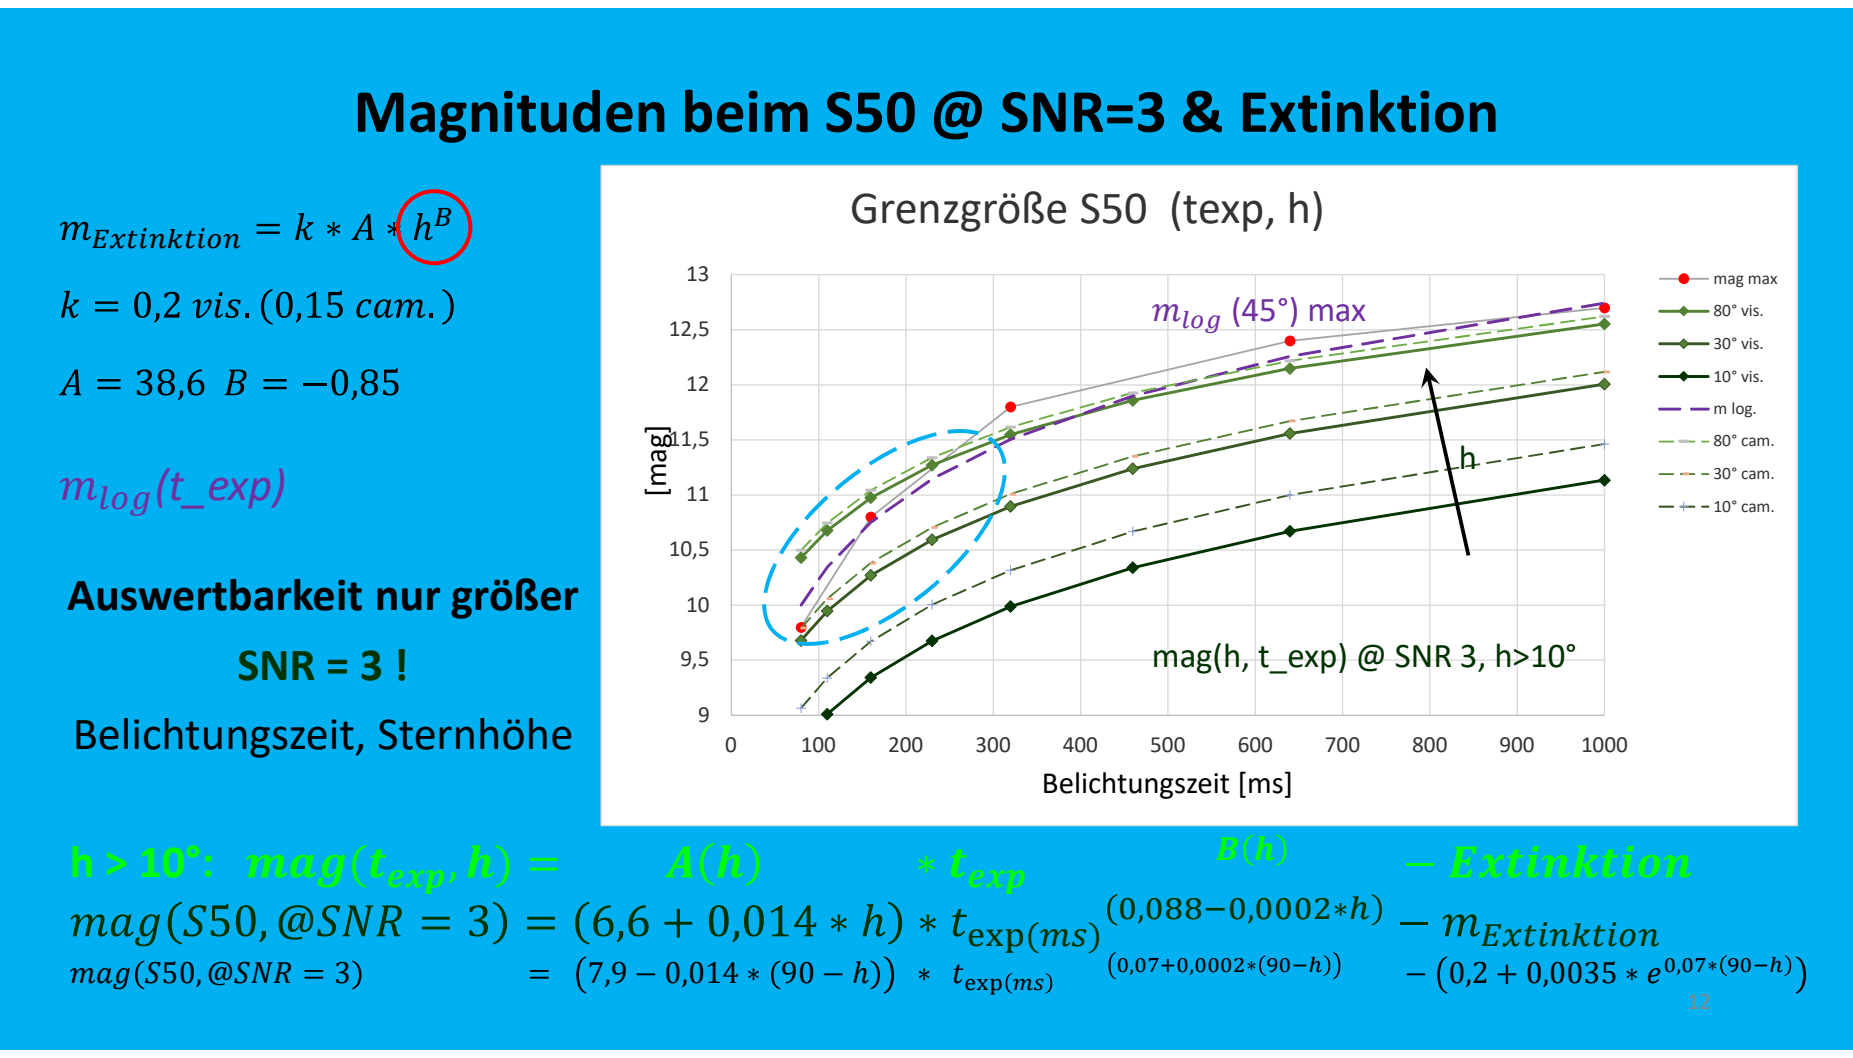
[picture p74: page 12]

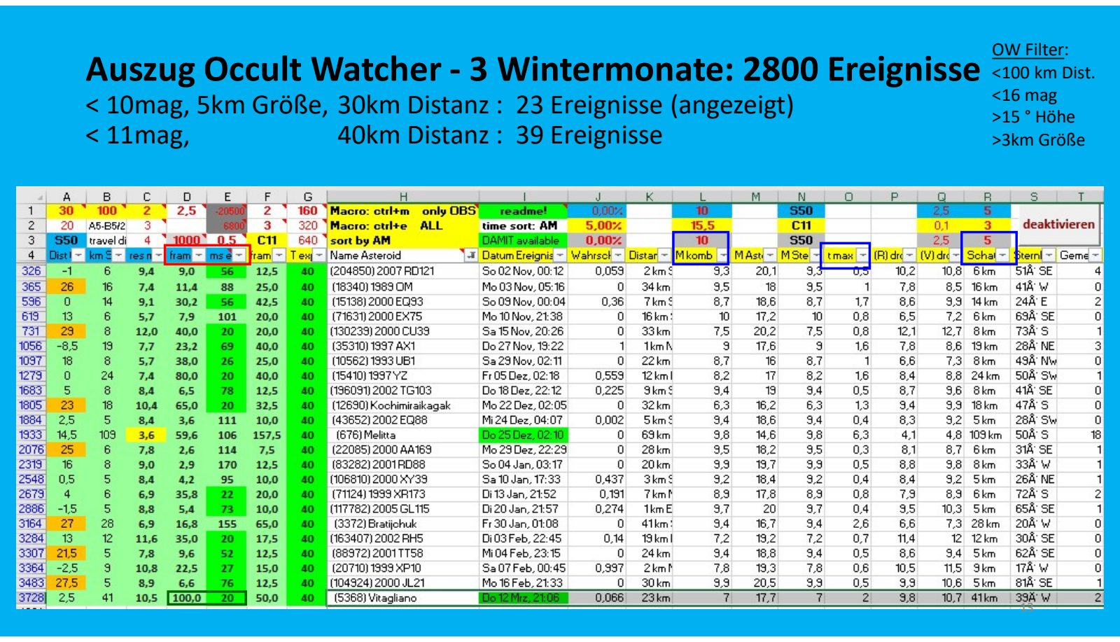
[picture p75: page 13]

Auszug Occult Watcher - 3 Wintermonate: 2800 Ereignisse
< 10mag, 5km Größe, 30km Distanz : 23 Ereignisse (angezeigt)
< 11mag, | 40km Distanz : 39 Ereignisse

13

OW Filter:
<100 km Dist.
<16 mag
>15 ° Höhe
>3km Größe


OW Cloud Filter

14

1.
2.

3.

JPL Seite


15

https://ssd.jpl.nasa.gov/horizons

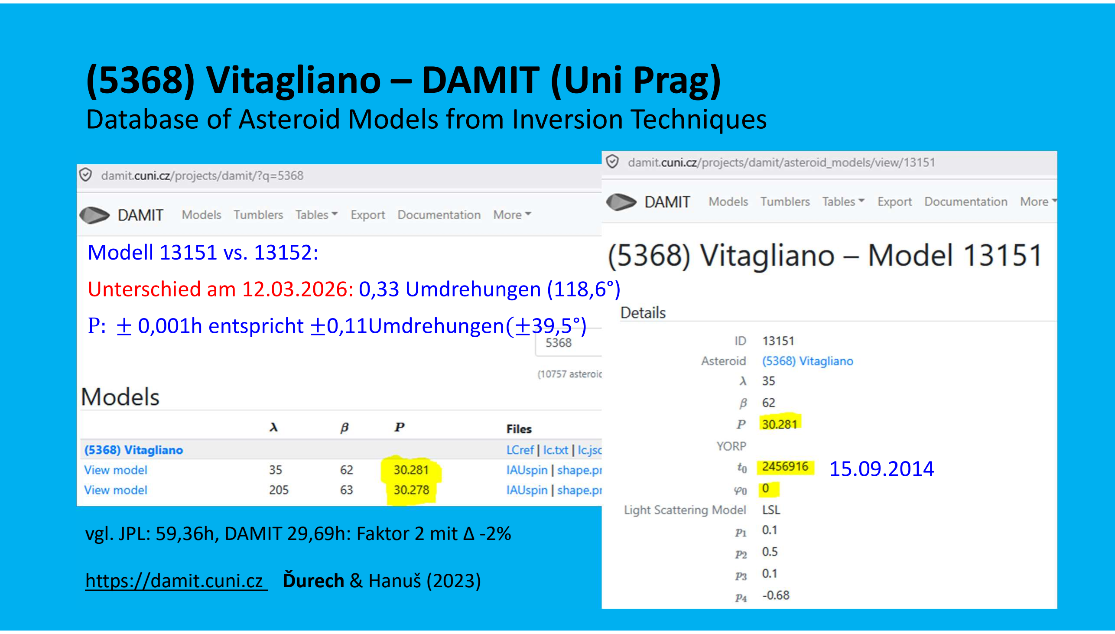
[picture p76: page 16]

(5368) Vitagliano – DAMIT (Uni Prag)
Database of Asteroid Models from Inversion Techniques

16

vgl. JPL: 59,36h, DAMIT 29,69h: Faktor 2 mit Δ -2%

Modell 13151 vs. 13152:
Unterschied am 12.03.2026: 0,33 Umdrehungen (118,6°)
0,001h entspricht | 0,11Umdrehungen | 39,5°)

15.09.2014

https://damit.cuni.cz Ďurech & Hanuš (2023)

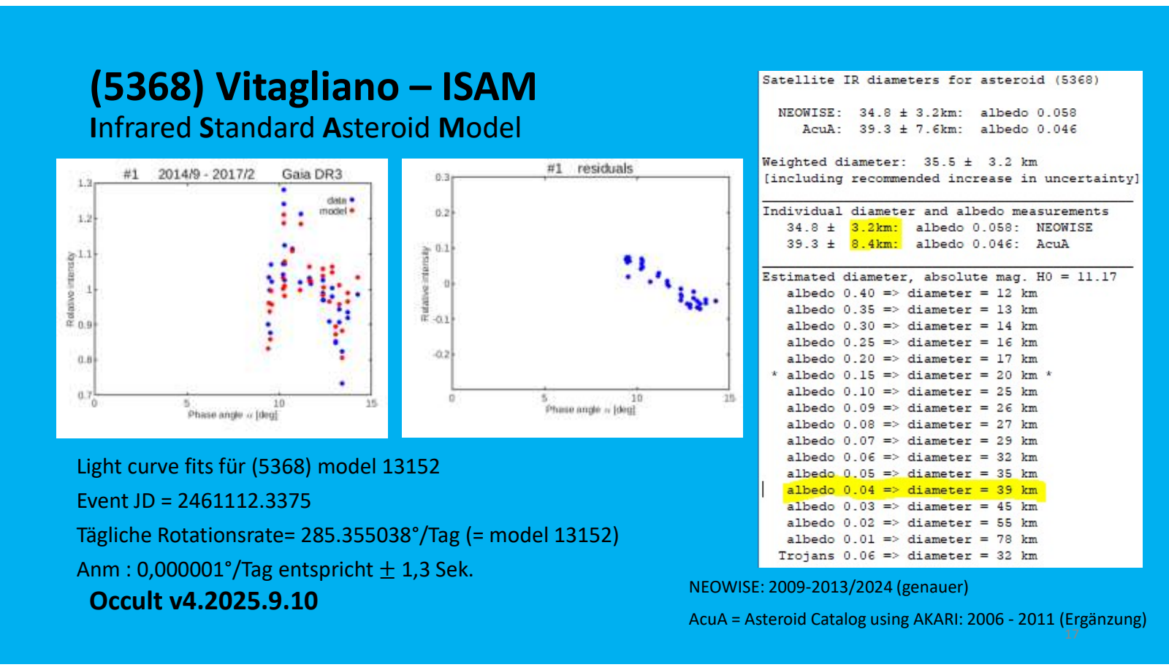
[picture p77: page 17]

Light curve fits für (5368) model 13152
Event JD = 2461112.3375
Tägliche Rotationsrate= 285.355038°/Tag (= model 13152) Anm : 0,000001°/Tag entspricht ± 1,3 Sek.

(5368) Vitagliano – ISAM
Infrared Standard Asteroid Model

17

Occult v4.2025.9.10 | NEOWISE: 2009-2013/2024 (genauer) AcuA = Asteroid Catalog using AKARI: 2006 - 2011 (Ergänzung)

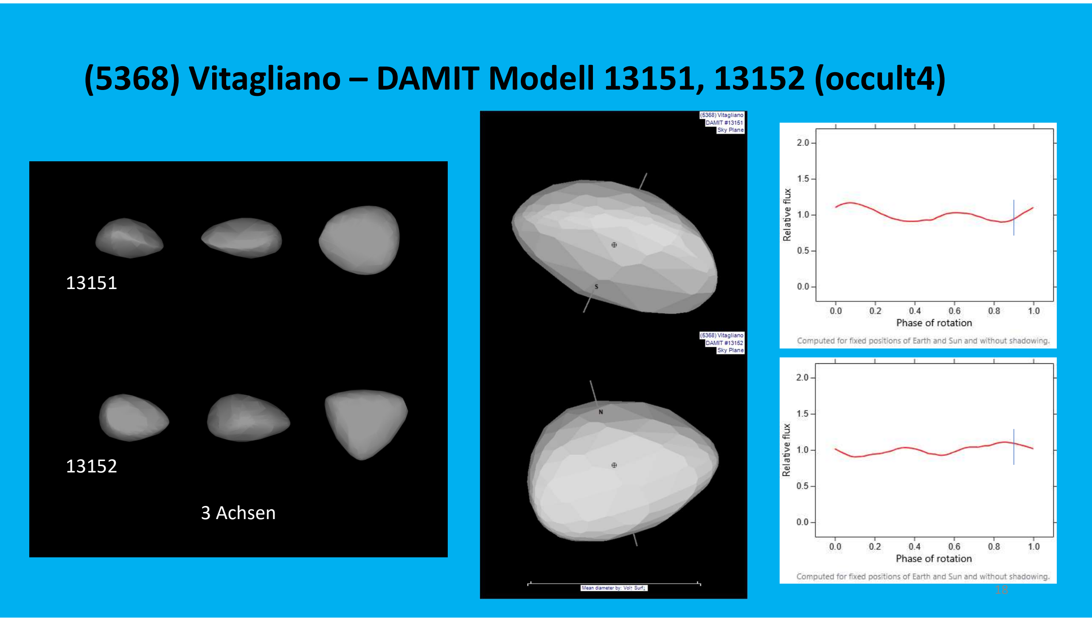
[picture p78: page 18]

(5368) Vitagliano – DAMIT Modell 13151, 13152 (occult4)

18

### 3 Achsen

13151

13152

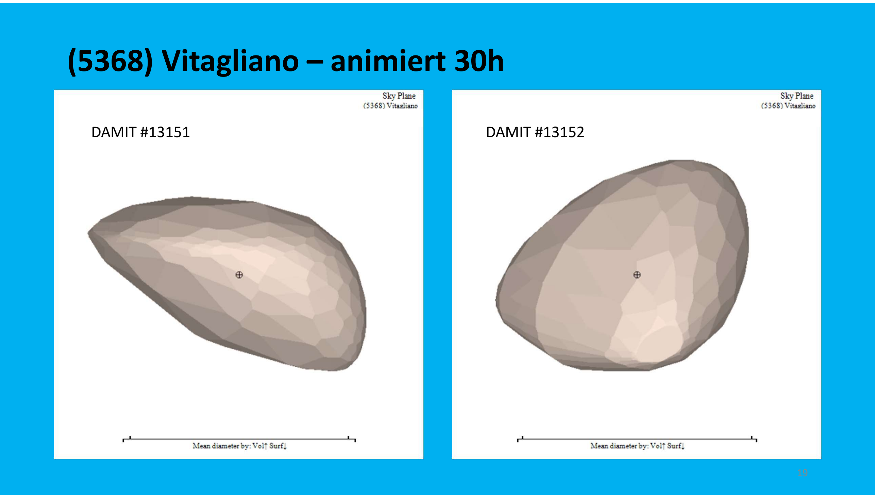
[picture p79: page 19]

(5368) Vitagliano – animiert 30h

19

DAMIT #13151 | DAMIT #13152

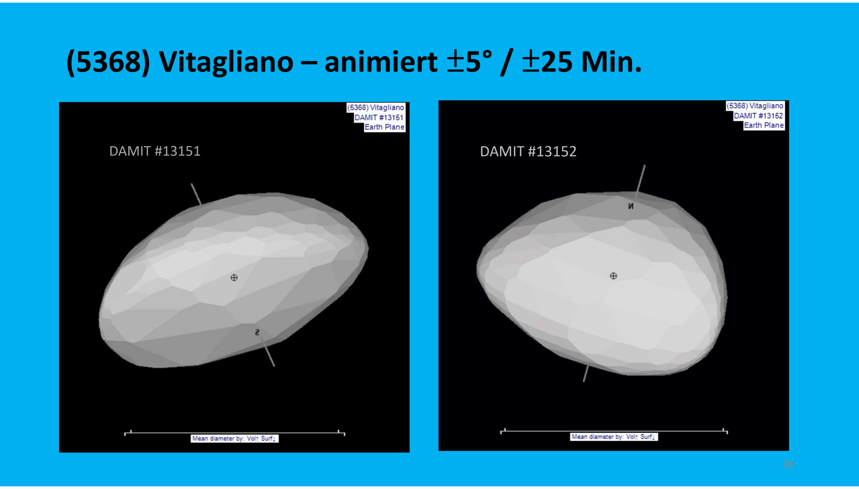
[picture p80: page 20]

(5368) Vitagliano – animiert ±5° / ±25 Min.

20

DAMIT #13151 DAMIT #13151 | DAMIT #13152


21

Expedition: Bedeckungspad und Standortplanung

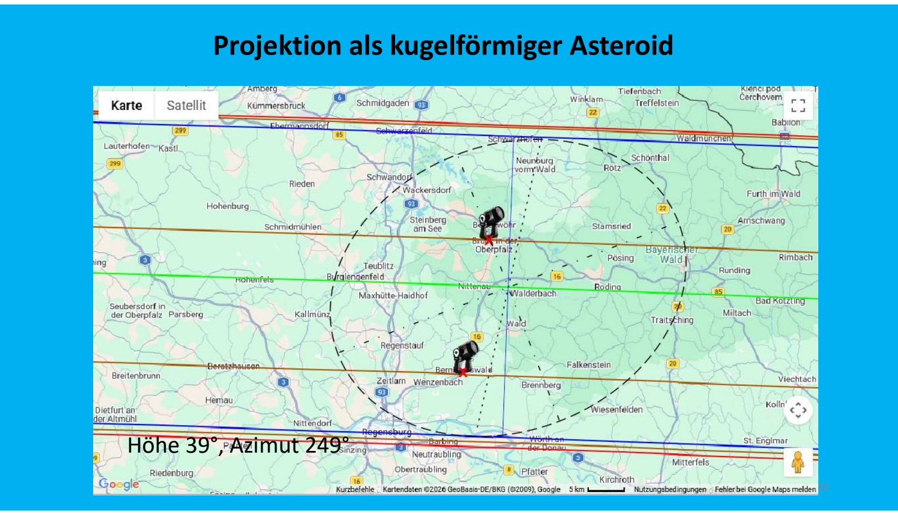
[picture p81: page 22]

22

Projektion als kugelförmiger Asteroid

Höhe 39°, Azimut 249°


23

Tatsächliche Standorte


24

Gemessene Zeiten korrigiert projiziert


25

(5368) Vitagliano – Modell #1: Vorhersage - Beobachtung


26

(5368) Vitagliano – Modell #2 : Vorhersage - Beobachtung

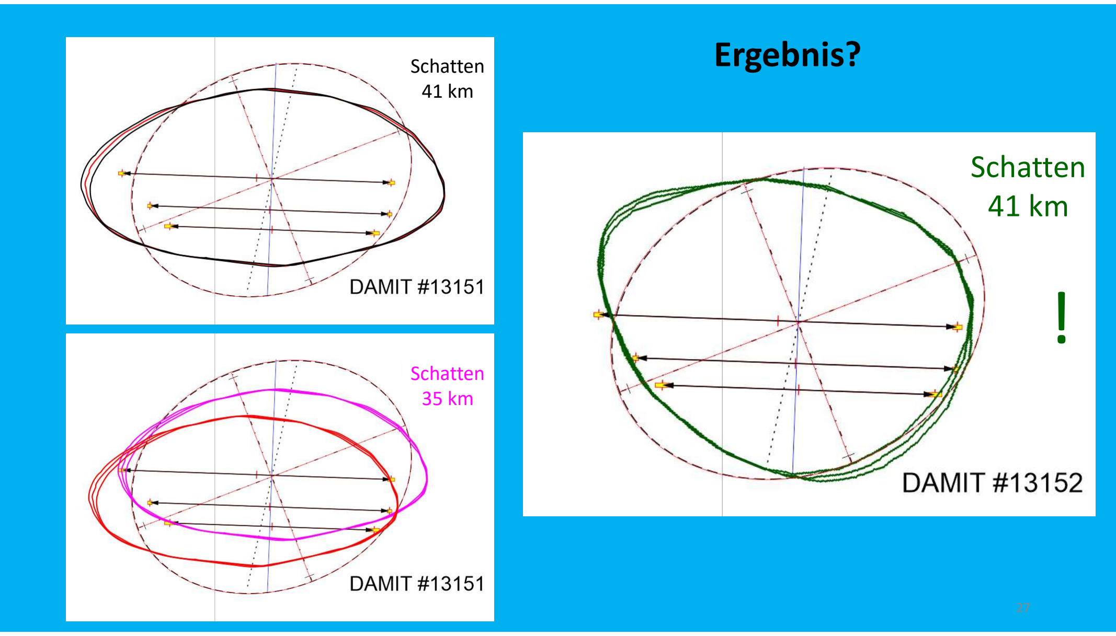
[picture p82: page 27]

27

!

Schatten | Ergebnis?

### 41 km

Schatten

### 35 km

Schatten

### 41 km

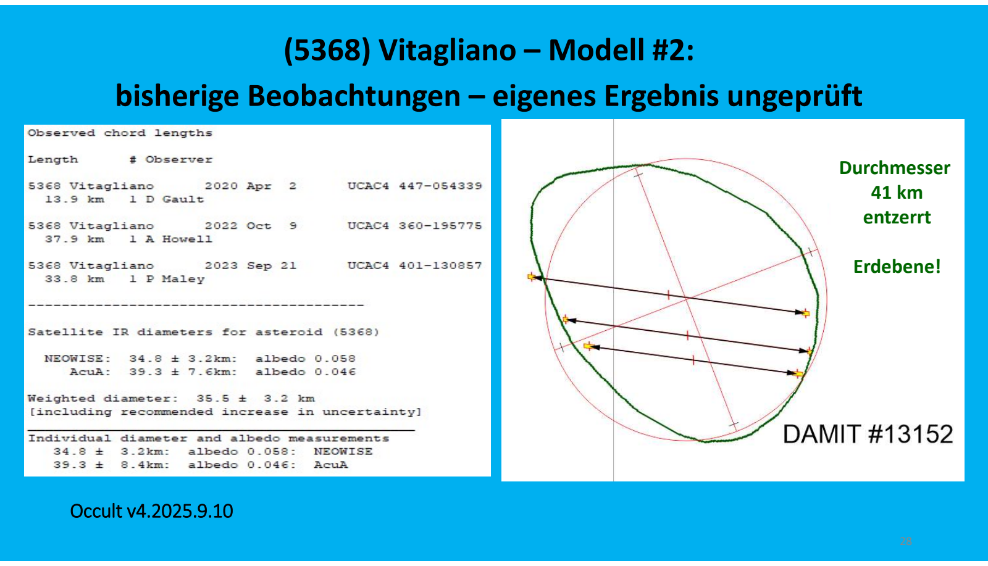
[picture p83: page 28]

28

!

(5368) Vitagliano – Modell #2: bisherige Beobachtungen – eigenes Ergebnis ungeprüft

Occult v4.2025.9.10

Durchmesser

### 41 km

entzerrt

Erdebene!

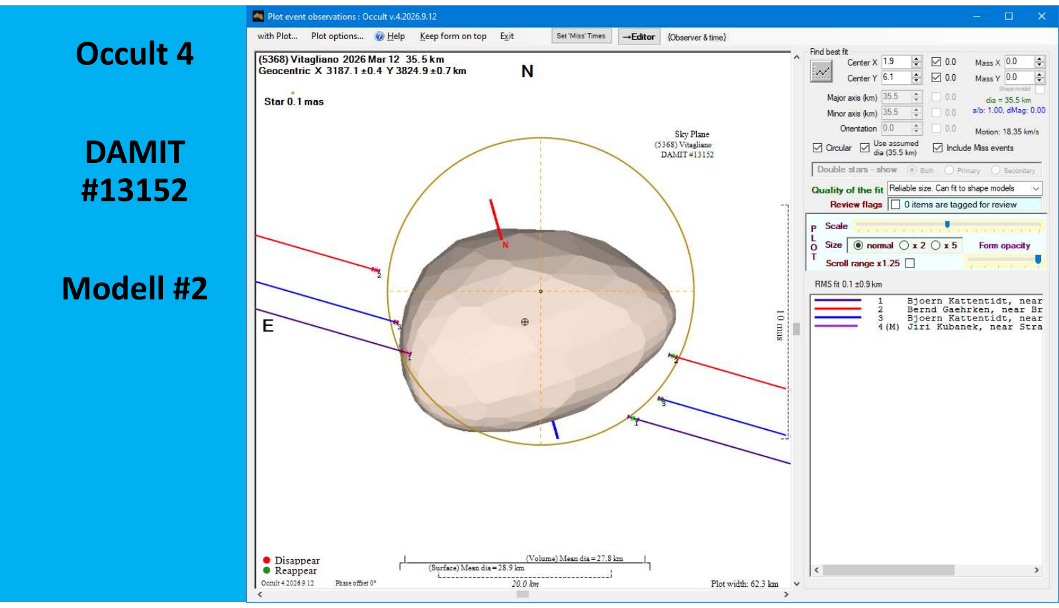
[picture p84: page 29]

29

Occult 4

DAMIT
#13152

Modell #2

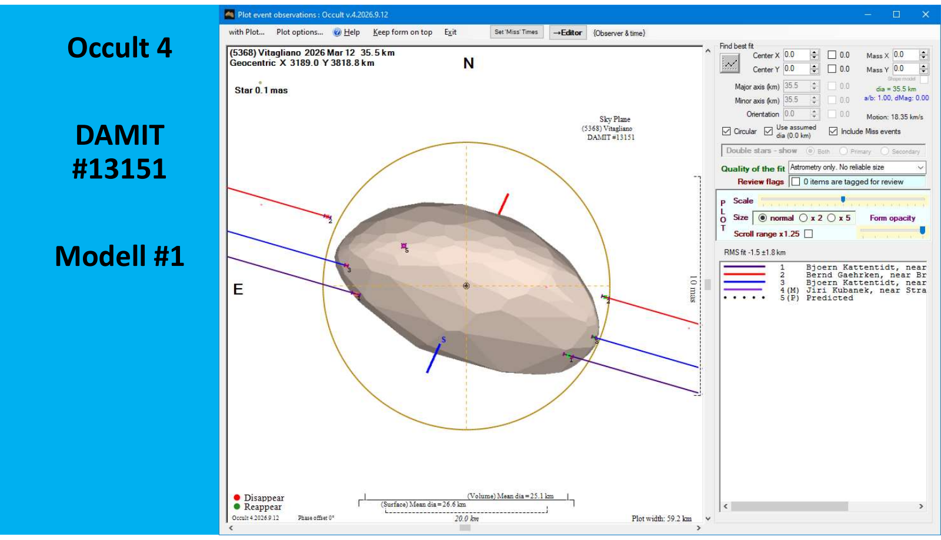
[picture p85: page 30]

30

Occult 4

DAMIT
#13151

Modell #1

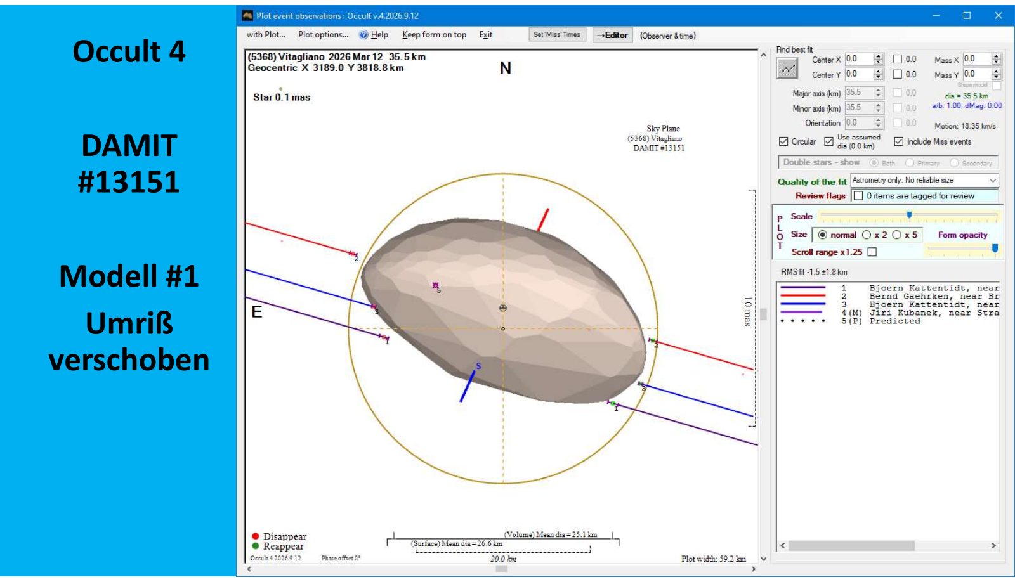
[picture p86: page 31]

31

Occult 4

DAMIT
#13151

Modell #1
Umriß
verschoben

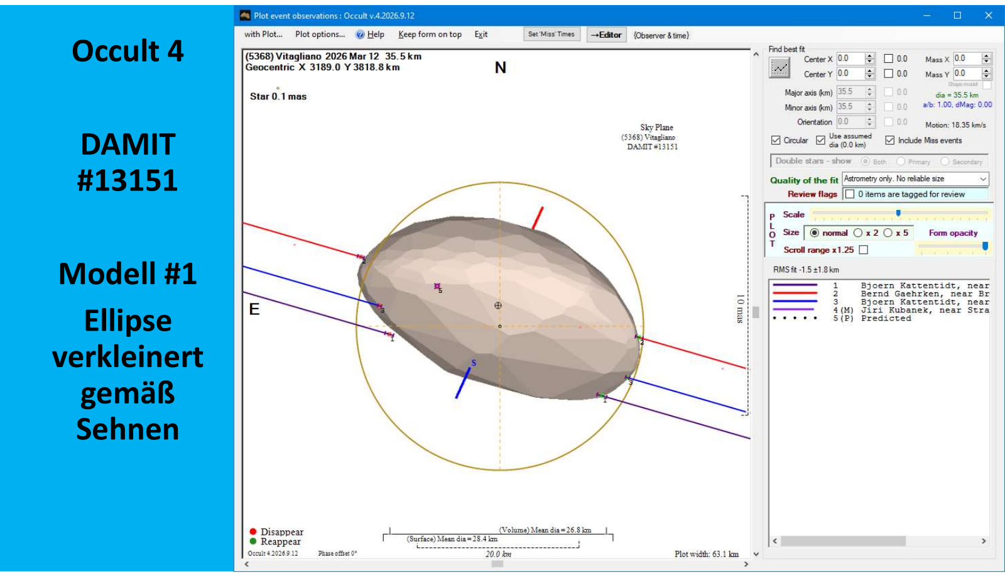
[picture p87: page 32]

32

Occult 4

DAMIT
#13151

Modell #1
Ellipse
verkleinert
gemäß
Sehnen

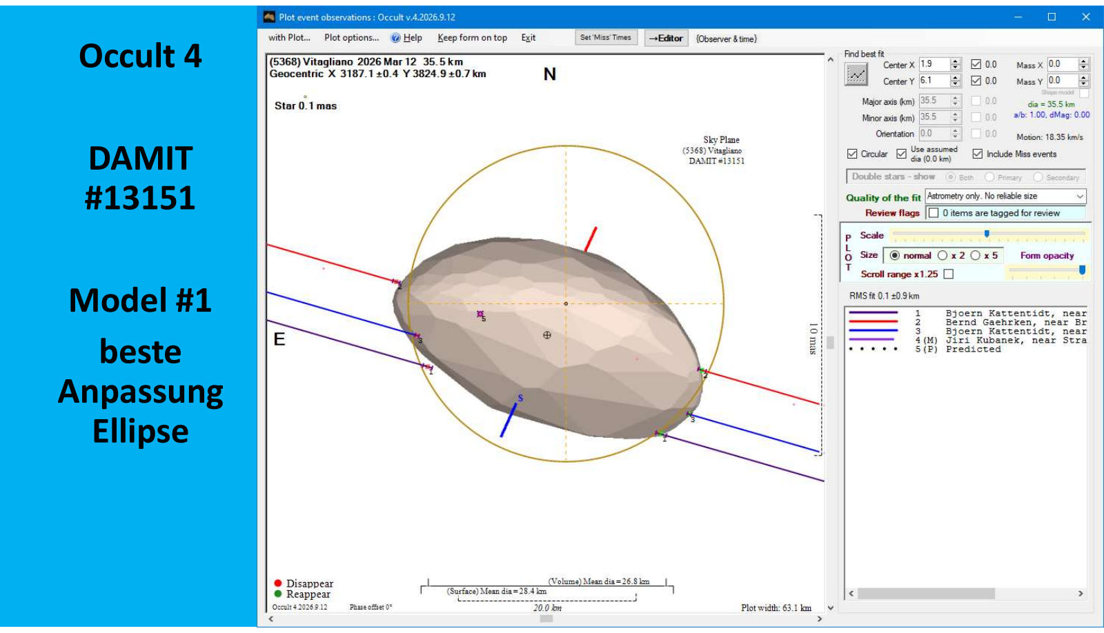
[picture p88: page 33]

33

Occult 4

DAMIT
#13151

Model #1
beste
Anpassung
Ellipse

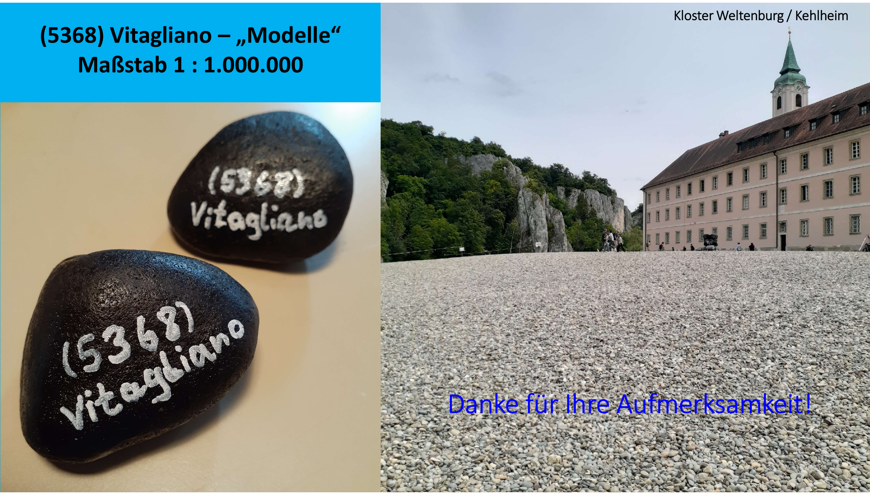
[picture p89: page 34]

34

Danke für Ihre Aufmerksamkeit!

(5368) Vitagliano – „Modelle“ Maßstab 1 : 1.000.000

Kloster Weltenburg / Kehlheim


35
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
