leontodon1/1pps_flasher/(commit log)

2026-03-02 docx v62 with buzzer
    [GPS_flash_fracture_GPS_v62.ino]
2026-06-03 Add files via upload
    v66: low battery indicator now resets after 3 sec. instead of switching the device on and off
    v65: buzzer beeps if something is not correct, all ok with no beeps
    v64: loop time optimization <100µs
    v63: loop time optimization 246µs
2026-10-17 Add files via upload
    Description how to evaluate flashes of the 1PS flasher using PyMovie / Py OTE at millisecond accuracy
